Sierra-Lobo/mainboard-hardware/revA-proto/images/mainboard_original.jpg

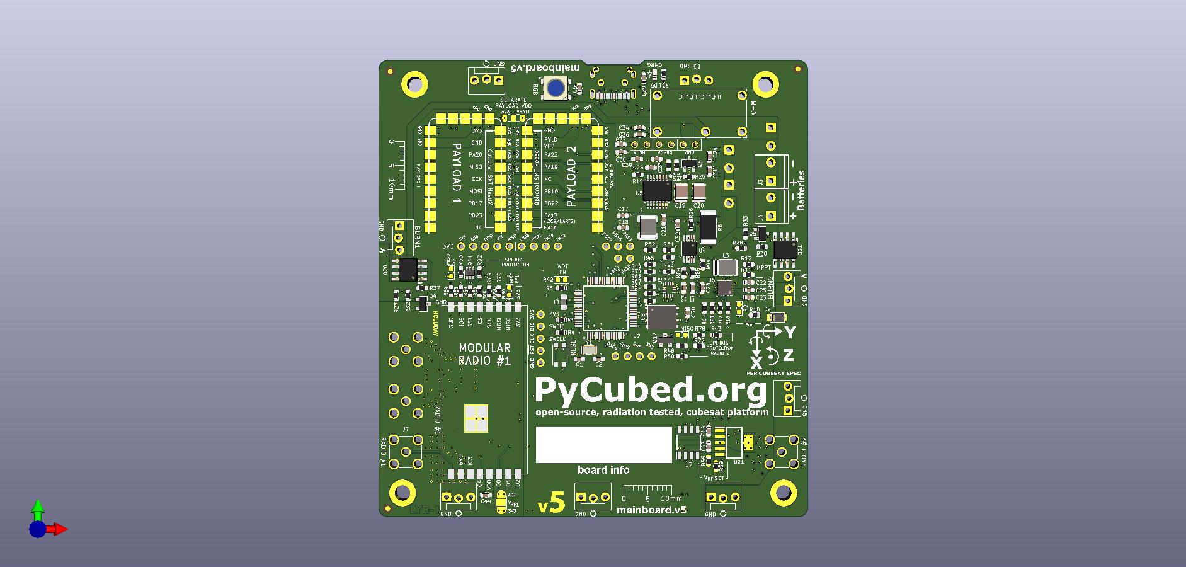
revA-proto/images/mainboard_original.jpg
