Sierra-Lobo/mainboard-hardware/revA-proto/images/mainboard.jpg

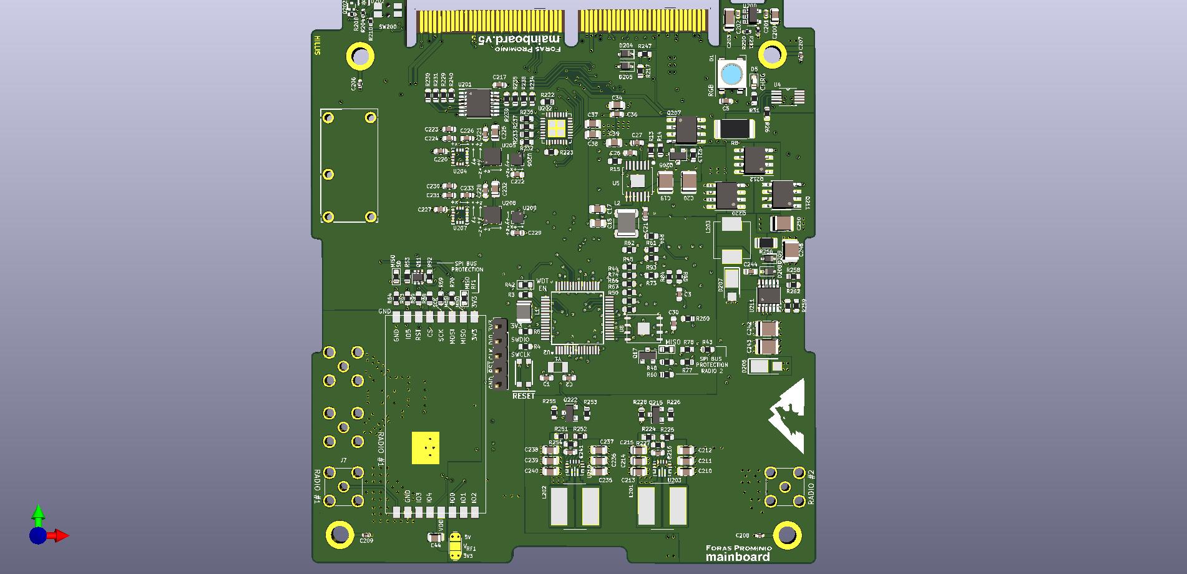
revA-proto/images/mainboard.jpg
