Sierra-Lobo/mainboard-hardware/README.md

# mainboard

PyCubed mainboard adaptation for use on Foras Promineo
