Sierra-Lobo/mainboard-hardware/design/stackup/RF_trace_calculation_1oz_1oz_FR408HR.PNG

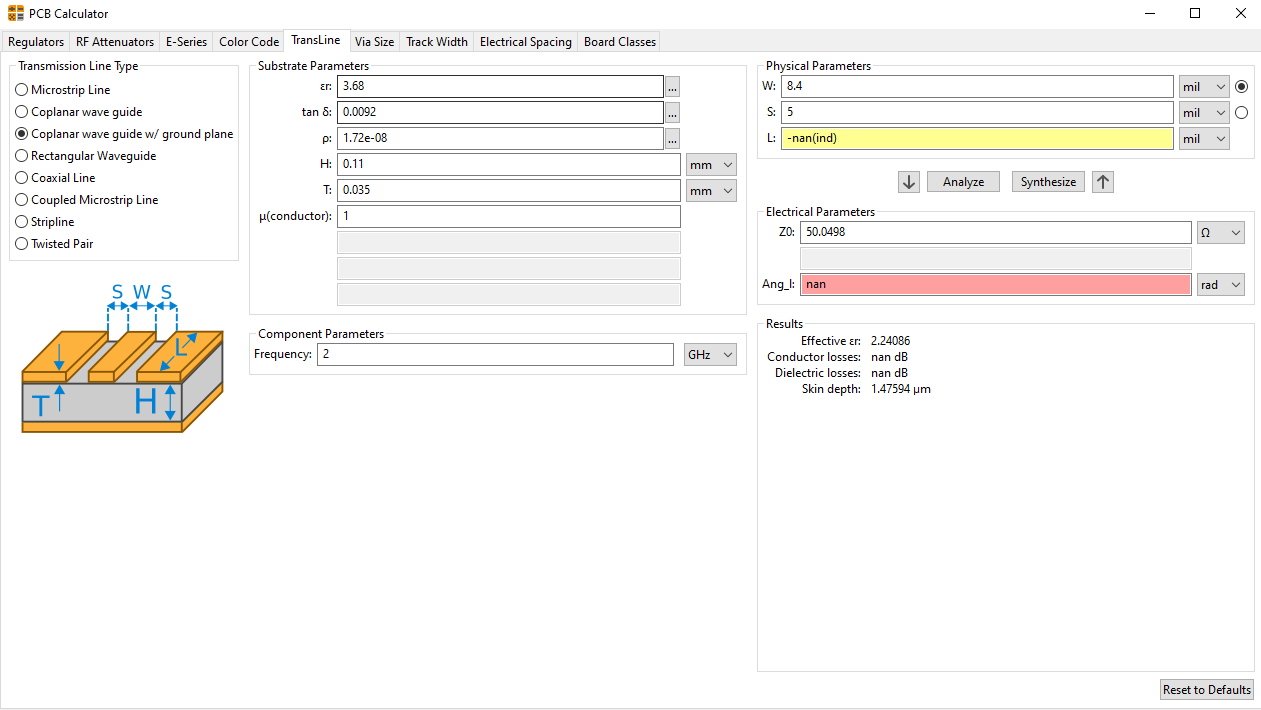
design/stackup/RF_trace_calculation_1oz_1oz_FR408HR.PNG
