Sierra-Lobo/mainboard-hardware/design/stackup/stackup.PNG

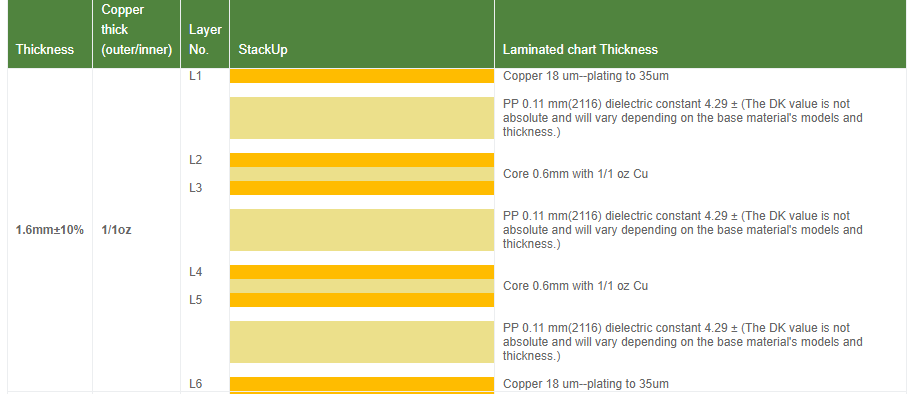
design/stackup/stackup.PNG
