Sierra-Lobo/mainboard-hardware/revC-fm/docs/mainboard-revC-3d-bot.jpg

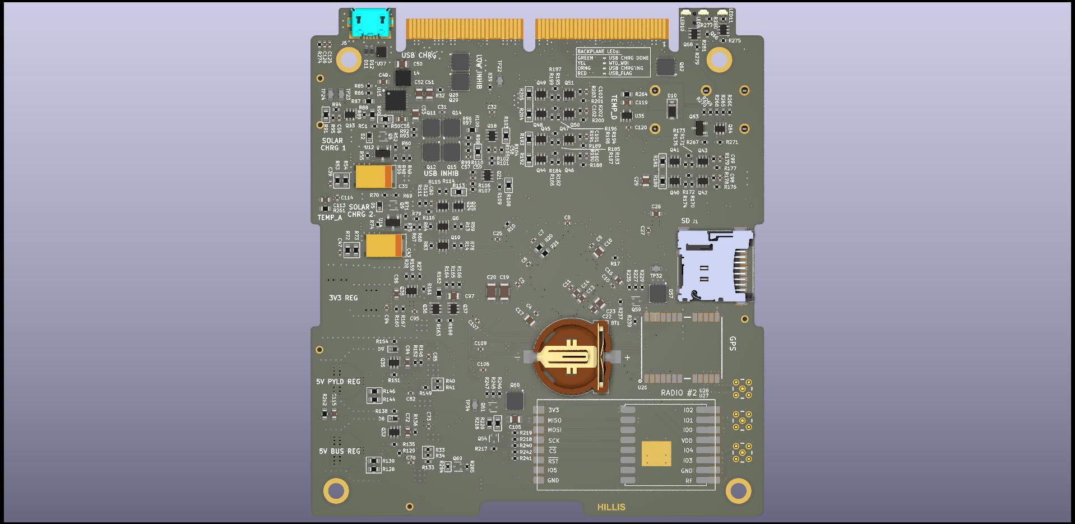
revC-fm/docs/mainboard-revC-3d-bot.jpg
