Sierra-Lobo/mainboard-hardware/revC-fm/docs/mainboard-revC-3d-top.jpg

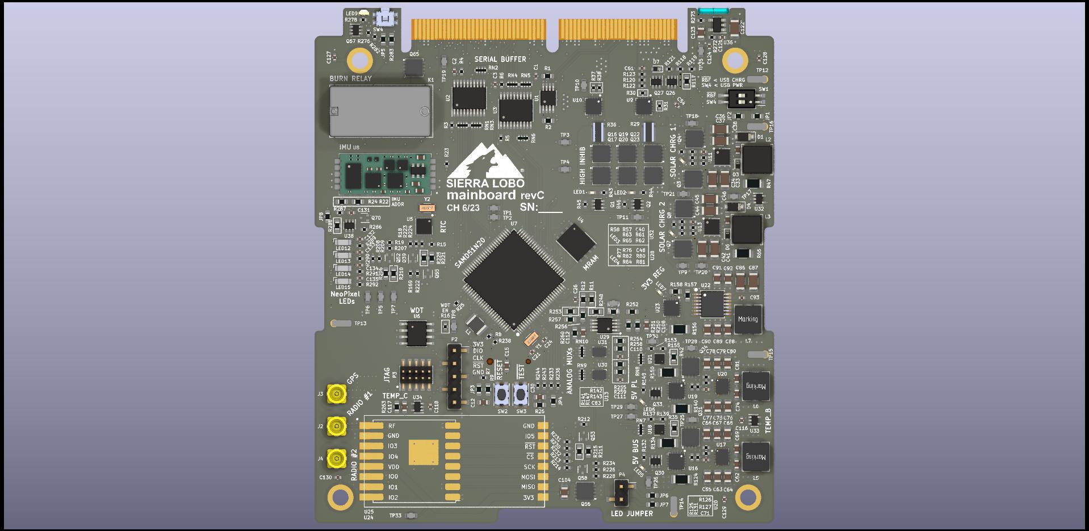
revC-fm/docs/mainboard-revC-3d-top.jpg
