Sierra-Lobo/mainboard-hardware/revC-fm/docs/stackup/PCBway_impedance_ms_se_cp_gp_50.JPG

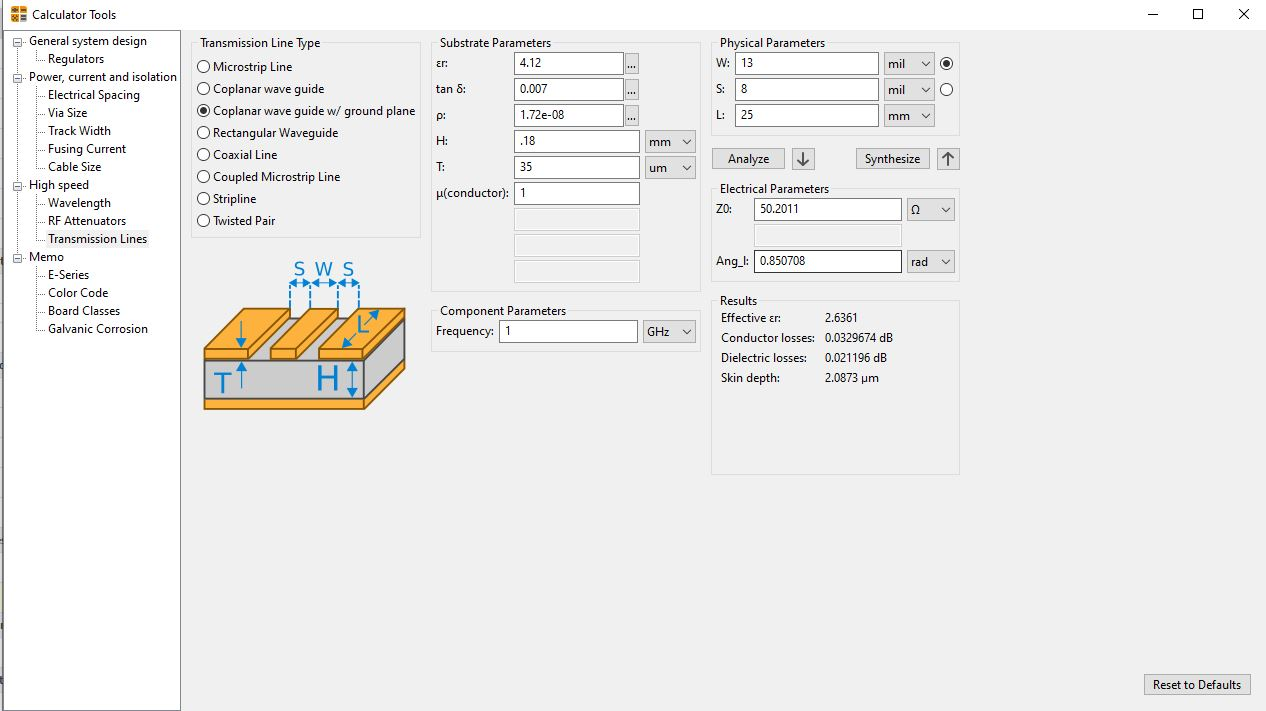
revC-fm/docs/stackup/PCBway_impedance_ms_se_cp_gp_50.JPG
