Sierra-Lobo/mainboard-hardware/revC-fm/docs/stackup/PCBway_impedance_sl_dp_90.JPG

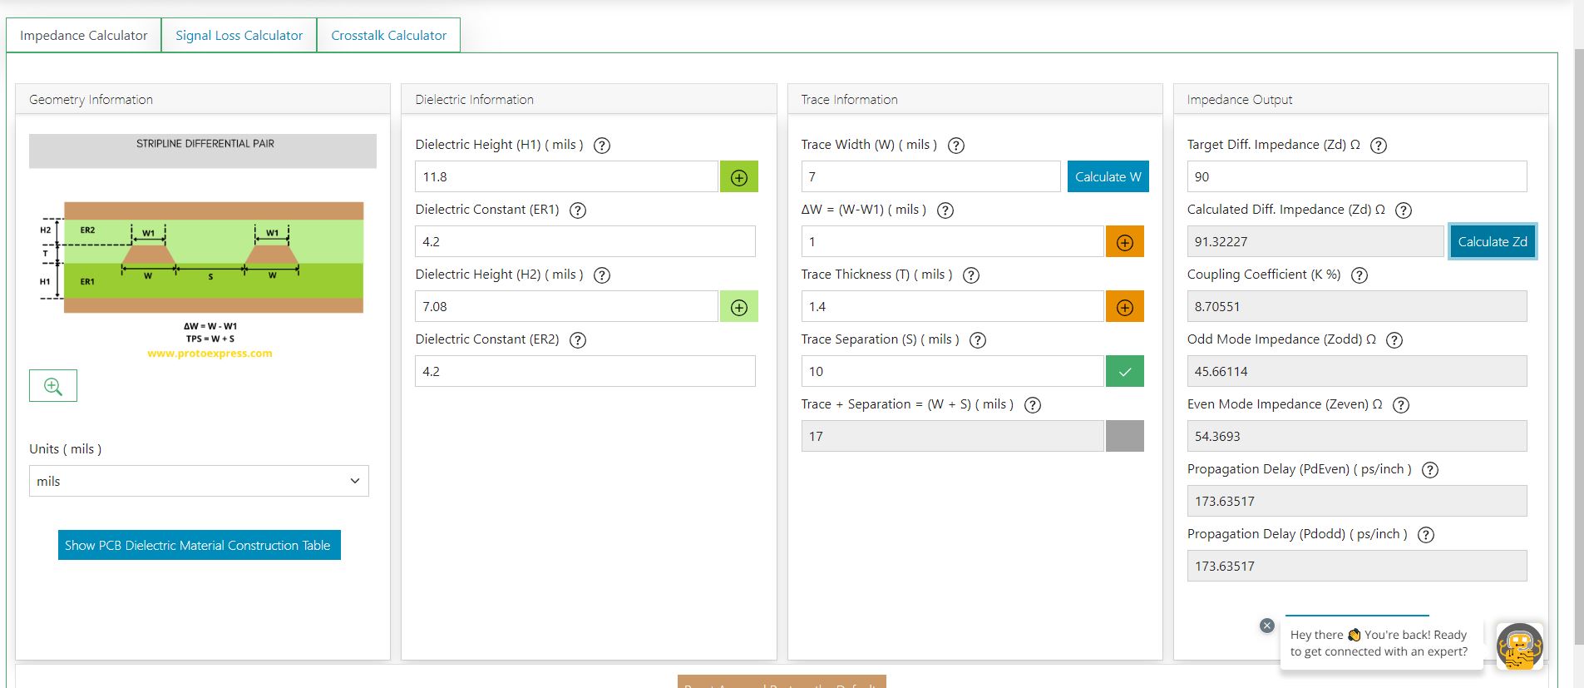
revC-fm/docs/stackup/PCBway_impedance_sl_dp_90.JPG
