Sierra-Lobo/mainboard-hardware/revC-fm/docs/stackup/PCBway_stackup.JPG

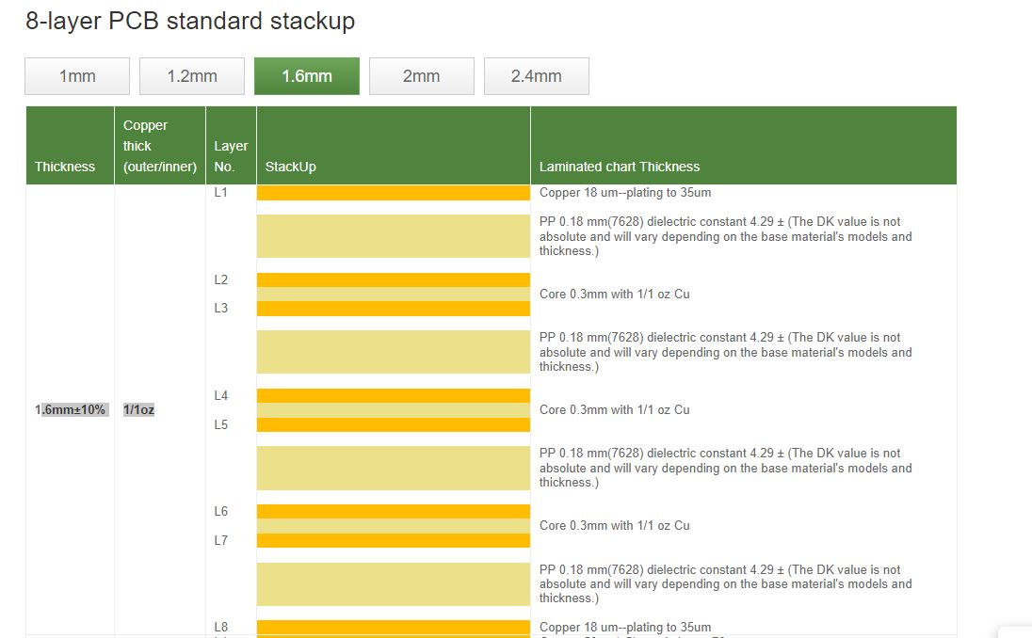
revC-fm/docs/stackup/PCBway_stackup.JPG
