Sierra-Lobo/mainboard-hardware/revC-fm/docs/mainboard-revC-assy-vendor-bom.xlsx

Item | Qty | Reference(s) | Value | Footprint | LibPart | Manufacturer | Mfr. Part No | Description | Datasheet
1 | 1 | BT1 | 1056TR | SierraLobo:Keystone_1056 | Device:Battery_Cell | Keystone Electronics | 1056TR | BATT HOLDER COIN 12.5MM 1CEL SMD | ~
2 | 8 | C1, C98, C99, C100, C101, C102, C103, C126 | 10nF | Capacitor_SMD:C_0402_1005Metric | Device:C | TDK | CGA2B3X7S2A103K050BB | CAP CER 10000PF 100V X7S 0402 | ~
3 | 50 | C2, C3, C4, C5, C6, C7, C8, C9, C10, C11, C25, C26, C27, C31, C32, C56, C57, C58, C59, C60, C61, C70, C71, C73, C82, C83, C85, C93, C95, C106, C107, C109, C110, C111, C114, C116, C118, C120, C121, C124, C125, C127, C128, C129, C130, C131, C132, C133, C134, C135 | 0.1uF | Capacitor_SMD:C_0402_1005Metric | Device:C | TDK | CGA2B3X7R1H104K050BE | CAP CER 0.1UF 50V X7R 0402 | ~
4 | 18 | C12, C13, C14, C15, C16, C22, C28, C30, C38, C46, C49, C72, C84, C96, C113, C115, C117, C119 | 1uF | Capacitor_SMD:C_0603_1608Metric | Device:C | TDK | CGA3E1X7R1V105K080AE | CAP CER 1UF 35V X7R 0603 | ~
5 | 15 | C17, C18, C23, C29, C50, C53, C66, C67, C68, C78, C79, C80, C91, C92, C123 | 10uF | Capacitor_SMD:C_0805_2012Metric | Device:C | TDK | CGA4J1X7S1E106K125AE | CAP CER 10UF 25V X7S 0805 | ~
6 | 5 | C19, C20, C86, C87, C122 | 47uF | Capacitor_SMD:C_1206_3216Metric | Device:C | TDK | C3216X5R1E476M160AC | CAP CER 47UF 25V X5R 1206 | ~
7 | 2 | C21, C24 | 8pF | Capacitor_SMD:C_0402_1005Metric | Device:C | TDK | CGA2B2NP01H080D050BA | CAP CER 8PF 50V NP0 0402 | ~
8 | 8 | C33, C34, C36, C37, C41, C42, C44, C45 | 10uF | Capacitor_SMD:C_1206_3216Metric | Device:C | TDK | CGA5L1X7R1V106M160AE | CAP CER 10UF 35V X7R 1206 | ~
9 | 2 | C35, C43 | 100uF | Capacitor_Tantalum_SMD:CP_EIA-7343-20_Kemet-V | Device:C_Polarized_US | Vishay Sprague | TR3D107K020C0080 | CAP TANT 100UF 10% 20V 2917 | ~
10 | 4 | C39, C40, C47, C48 | 33pF | Capacitor_SMD:C_0402_1005Metric | Device:C | TDK | CGA2B2NP01H330J050BA | CAP CER 33PF 50V NP0 0402 | ~
11 | 11 | C51, C52, C63, C64, C65, C75, C76, C77, C88, C89, C90 | 22uF | Capacitor_SMD:C_0805_2012Metric | Device:C | Murata | GRT21BR61C226ME13K | CAP CER 22UF 16V X5R 0805 | ~
12 | 1 | C54 | 47nF | Capacitor_SMD:C_0402_1005Metric | Device:C | TDK | CGA2B3X7R1H473K050BB | CAP CER 0.047UF 50V X7R 0402 | ~
13 | 1 | C55 | 4.7uF | Capacitor_SMD:C_0603_1608Metric | Device:C | Murata | GRT188R61C475KE13J | CAP CER 4.7UF 16V X5R 0603 | ~
14 | 4 | C62, C69, C74, C81 | 10uF | Capacitor_SMD:C_0603_1608Metric | Device:C | Murata | GRT188R61E106ME13D | CAP CER 10UF 25V X5R 0603 | ~
15 | 1 | C94 | 3.3nF | Capacitor_SMD:C_0402_1005Metric | Device:C | TDK | CGA2B2X7R1H332K050BA | CAP CER 3300PF 50V X7R 0402 | ~
16 | 2 | C97, C104 | 10uF | Capacitor_SMD:C_0805_2012Metric | Device:C_Small | TDK | CGA4J1X7S1E106K125AE | CAP CER 10UF 25V X7S 0805 | ~
17 | 2 | C108, C112 | 10nF | Capacitor_SMD:C_0603_1608Metric | Device:C | TDK | CGA3E2X7R1H103K080AE | CAP CER 10000PF 50V X7R 0603 | ~
18 | 3 | D1, D4, D10 | B260S1F-7 | Diode_SMD:D_SOD-123F | mainboard-rescue:D_Schottky-Device-mainboard-rescue | Diodes Incorporated | B260S1F-7 | DIODE SCHOTTKY 60V 2A SOD123F
19 | 2 | D2, D5 | 20V | Diode_SMD:D_SOD-523 | Device:D_Zener | Diodes Incorporated | BZT585B20T-7 | DIODE ZENER 20V 350MW SOD523 | ~
20 | 5 | D3, D6, D7, D8, D9 | 1SS400T1G | Diode_SMD:D_SOD-523 | Device:D | onsemi | 1SS400T1G | DIODE GEN PURP 100V 200MA SOD523 | ~
21 | 2 | D11, D12 | ESD321DPYR | SierraLobo:D_0402_1005Metric | Device:D_Zener | Texas Instruments | ESD321DPYR | TVS DIODE 3.6VWM 6.8VC 2X1SON | ~
22 | 1 | J1 | 5031821852 | SierraLobo:MOLEX_503182-1852 | SierraLobo:503182-1852 | Molex | 5031821852 | MICRO SD NORMAL ULTRALOWPRO8CKTE
23 | 1 | J5 | ZX62-AB-5PA(31) | SierraLobo:ZX62-AB-5PA(31) | Connector:USB_B_Micro | Hirose Electric | ZX62-AB-5PA(31) | CONN RCPT USB2.0 MICRO AB SMD RA | ~
24 | 1 | L1 | 10uH | Inductor_SMD:L_1210_3225Metric | Device:L | TDK | BCL322520RT-100M-D | FIXED IND WW SHEILD 10UH 1.72A 230MOHM 1210 | ~
25 | 2 | L2, L3 | 33uH | Inductor_SMD:L_Coilcraft_XAL5050-XXX | Device:L | Coilcraft | XGL5050-333MEC | FIXED IND MLD SHEILD 33UH 3.2A 118MOHM 5050 | ~
26 | 1 | L4 | 1uH | SierraLobo:74404032010 | Device:L | WÃ¼rth Elektronik | 74404032010 | FIXED IND SHEILD 1UH 2.2A 33 MOHM 3015 | ~
27 | 2 | L5, L6 | 1.5uH | SierraLobo:L_Wuerth_HCI-5040 | Device:L | WÃ¼rth Elektronik | 744316150 | FIXED IND SHEILD 1.5UH 9A 8.15 MOHM 5040 | ~
28 | 1 | L7 | 3.3uH | SierraLobo:L_Wuerth_HCI-5040 | Device:L | WÃ¼rth Elektronik | 744316330 | FIXED IND SHEILD3.3UH 5.75A 18.5 MOHM 5040 | ~
29 | 7 | LED1, LED2, LED3, LED4, LED5, LED6, LED7 | YEL | LED_SMD:LED_0402_1005Metric | Device:LED | Kingbright | APHHS1005LSYCK/J3-PF | LED YELLOW CLEAR 2SMD | ~
30 | 1 | LED8 | YELLOW | SierraLobo:APA2107x | Device:D | Kingbright | APA2107SYCK | LED YELLOW CLEAR SMD R/A | ~
31 | 1 | LED9 | GREEN | SierraLobo:APA2107x | Device:D | Kingbright | APA2107CGCK | LED GREEN CLEAR SMD R/A | ~
32 | 1 | LED10 | ORANGE | SierraLobo:APA2107x | Device:D | Kingbright | APA2107SECK | LED ORANGE CLEAR SMD R/A | ~
33 | 1 | LED11 | RED | SierraLobo:APA2107x | Device:D | Kingbright | APA2107LSECK | LED RED CLEAR SMD R/A | ~
34 | 1 | P3 | FTSH-105-01-F-DV-K-TR | Connector_PinHeader_1.27mm:PinHeader_2x05_P1.27mm_Vertical_SMD | Connector_Generic:Conn_02x05_Odd_Even | Samtec | FTSH-105-01-F-DV-K-TR | CONN HEADER SMD 10POS 1.27MM | ~
35 | 1 | P4 | TSM-102-01-L-SV-P-TR | Connector_PinHeader_2.54mm:PinHeader_1x02_P2.54mm_Vertical_SMD_Pin1Right | Connector_Generic:Conn_01x02 | Samtec | TSM-102-01-L-SV-P-TR | CONN HEADER SMD 2POS 2.54MM | ~
36 | 17 | Q1, Q2, Q6, Q10, Q13, Q18, Q21, Q24, Q27, Q30, Q32, Q33, Q35, Q38, Q66, Q67, Q68 | MMDT3946 | Package_TO_SOT_SMD:SOT-363_SC-70-6 | Transistor_BJT:MMDT3946 | Diodes Incorporated | MMDT3946-7-F | TRANS NPN/PNP 40V 0.2A SOT363 | http://www.diodes.com/_files/datasheets/ds30123.pdf
37 | 20 | Q3, Q4, Q7, Q8, Q11, Q12, Q14, Q15, Q16, Q17, Q19, Q20, Q22, Q23, Q31, Q34, Q56, Q57, Q62, Q65 | BSZ180 | SierraLobo:PG-TSDSON-8_3.3x3.3mm | SierraLobo:BSZ086 | Infineon | BSZ180P03NS3GATMA1 | MOSFET P-CH 30V 9A/39.6A TSDSON | https://www.infineon.com/dgdl/Infineon-BSZ180P03NS3_G-DS-v02_01-en.pdf?fileId=db3a304326dfb13001271f04398f4ec1
38 | 6 | Q5, Q9, Q39, Q58, Q59, Q69 | MMBT3904T | Package_TO_SOT_SMD:SOT-523 | Device:Q_NPN_BEC | Diodes Incorporated | MMBT3904T-7-F | TRANS NPN 40V 0.2A SOT523 | https://www.diodes.com/assets/Datasheets/ds30270.pdf
39 | 11 | Q25, Q26, Q36, Q37, Q40, Q41, Q44, Q45, Q48, Q49, Q64 | MMDT5551-7-F | Package_TO_SOT_SMD:SOT-363_SC-70-6 | Transistor_BJT:MMDT5551 | Diodes Incorporated | MMDT5551-7-F | TRANS 2NPN 160V 0.2A SOT363 | http://www.diodes.com/_files/datasheets/ds30172.pdf
40 | 2 | Q28, Q29 | BSZ025 | SierraLobo:PG-TSDSON-8_3.3x3.3mm | SierraLobo:BSZ025 | Infineon | BSZ025N04LSATMA1 | MOSFET N-CH 40V 22A/40A TSDSON | https://www.infineon.com/dgdl/DS_BSZ025N04LS_2_1.pdf?fileId=5546d46146d18cb40147204a34530283
41 | 6 | Q42, Q43, Q46, Q47, Q50, Q51 | BSS138DWQ-7 | Package_TO_SOT_SMD:SOT-363_SC-70-6 | SierraLobo:BSS138DW | Diodes Incorporated | BSS138DWQ-7 | MOSFET 2NCH 50V 200MA SOT363 | https://www.diodes.com/assets/Datasheets/BSS138DWQ.pdf
42 | 5 | Q52, Q53, Q54, Q55, Q70 | MMBT3906T | Package_TO_SOT_SMD:SOT-523 | Device:Q_PNP_BEC | Diodes Incorporated | MMBT3906T-7-F | TRANS PNP 40V 0.2A SOT523 | https://www.diodes.com/assets/Datasheets/ds30271.pdf
43 | 1 | Q63 | IRLML2803 | Package_TO_SOT_SMD:SOT-23 | Device:Q_NMOS_GSD | Infineon | IRLML2803TRPBF | MOSFET N-CH 30V 1.2A SOT23 | ~
44 | 4 | R1, R2, R20, R21 | 2.7k | Resistor_SMD:R_0603_1608Metric | Device:R_US | Stackpole Electronics | RMCF0603FT2K70 | RES 2.7K OHM 1% 1/10W 0603 | ~
45 | 61 | R3, R4, R5, R6, R13, R14, R27, R28, R30, R31, R33, R34, R37, R38, R40, R41, R48, R50, R67, R69, R92, R93, R96, R97, R101, R102, R106, R107, R111, R112, R122, R123, R135, R139, R151, R155, R208, R209, R213, R214, R218, R219, R223, R224, R228, R229, R231, R232, R233, R236, R237, R238, R239, R266, R267, R270, R287, R289, R290, R291, R292 | 1k | Resistor_SMD:R_0402_1005Metric | Device:R_US | Panasonic | ERJ-2GEJ102X | RES SMD 1K OHM 5% 1/10W 0402 | ~
46 | 39 | R7, R8, R10, R15, R16, R17, R18, R19, R23, R25, R32, R39, R85, R89, R129, R137, R145, R153, R159, R166, R169, R170, R171, R172, R173, R182, R183, R184, R185, R194, R195, R196, R197, R230, R272, R273, R275, R285, R286 | 10k | Resistor_SMD:R_0402_1005Metric | Device:R_US | Stackpole Electronics | RMCF0402FT10K0 | RES 10K OHM 1% 1/16W 0402 | ~
47 | 2 | R9, R26 | 330 | Resistor_SMD:R_0603_1608Metric | Device:R_US | Stackpole Electronics | RMCF0603FT330R | RES 330 OHM 1% 1/10W 0603 | ~
48 | 1 | R11 | 316k | Resistor_SMD:R_0603_1608Metric | Device:R_US | Stackpole Electronics | RMCF0603FT316K | RES 316K OHM 1% 1/10W 0603 | ~
49 | 3 | R12, R256, R260 | 110k | Resistor_SMD:R_0603_1608Metric | Device:R_US | Stackpole Electronics | RMCF0603FT110K | RES 110K OHM 1% 1/10W 0603 | ~
50 | 1 | R22 | 976k | Resistor_SMD:R_0603_1608Metric | Device:R_US | Stackpole Electronics | RMCF0603FT976K | RES 976K OHM 1% 1/10W 0603 | ~
51 | 1 | R24 | 102k | Resistor_SMD:R_0603_1608Metric | Device:R_US | Stackpole Electronics | RMCF0603FG102K | RES 102K OHM 1% 1/10W 0603 | ~
52 | 2 | R29, R36 | 10mR | SierraLobo:KRL3216 | SierraLobo:R_US_SENSE | Susumu | KRL3216T4A-M-R010-F-T1 | RES 0.01 OHM 1W 1206 WIDE | ~
53 | 2 | R35, R42 | 499 | Resistor_SMD:R_0603_1608Metric | Device:R_US | Stackpole Electronics | RMCF0603FT499R | RES 499 OHM 1% 1/10W 0603 | ~
54 | 11 | R43, R44, R60, R79, R132, R148, R161, R277, R278, R279, R280 | 1.5k | Resistor_SMD:R_0402_1005Metric | Device:R_US | Stackpole Electronics | RMCF0402FT1K50 | RES 1.5K OHM 1% 1/16W 0402 | ~
55 | 50 | R45, R46, R49, R51, R55, R58, R59, R64, R68, R70, R74, R77, R78, R83, R94, R125, R126, R127, R131, R133, R136, R138, R141, R142, R143, R147, R149, R152, R154, R160, R163, R165, R167, R176, R177, R188, R189, R200, R201, R226, R227, R234, R235, R265, R268, R269, R271, R276, R281, R282 | 100k | Resistor_SMD:R_0402_1005Metric | Device:R_US | Stackpole Electronics | RMCF0402FT100K | RES 100K OHM 1% 1/16W 0402 | ~
56 | 2 | R47, R66 | 120mR | Resistor_SMD:R_1206_3216Metric | Device:R_US | Susumu | KRL1632E-M-R120-F-T5 | RES 0.12 OHM 1% 3/4W 1206 | ~
57 | 2 | R52, R71 | 180k | Resistor_SMD:R_0402_1005Metric | Device:R_US | Stackpole Electronics | RMCF0402FT180K | RES 180K OHM 1% 1/16W 0402 | ~
58 | 2 | R53, R72 | 634k | Resistor_SMD:R_0603_1608Metric | Device:R_US | Stackpole Electronics | RMCF0603FT634K | RES 634K OHM 1% 1/10W 0603 | ~
59 | 2 | R54, R73 | 412k | Resistor_SMD:R_0603_1608Metric | Device:R_US | Stackpole Electronics | RMCF0603FT412K | RES 412K OHM 1% 1/10W 0603 | ~
60 | 2 | R56, R75 | 2.61k | Resistor_SMD:R_0402_1005Metric | Device:R_US | Stackpole Electronics | RMCF0402FT2K61 | RES 2.61K OHM 1% 1/16W 0402 | ~
61 | 10 | R57, R76, R104, R109, R114, R115, R118, R119, R121, R274 | 1Meg | Resistor_SMD:R_0402_1005Metric | Device:R_US | Stackpole Electronics | RMCF0402FT1M00 | RES 1M OHM 1% 1/16W 0402 | ~
62 | 2 | R61, R80 | 140k | Resistor_SMD:R_0402_1005Metric | Device:R_US | Stackpole Electronics | RMCF0402FT140K | RES 140K OHM 1% 1/16W 0402 | ~
63 | 2 | R62, R81 | 2.8k | Resistor_SMD:R_0402_1005Metric | Device:R_US | Stackpole Electronics | RMCF0402FT2K80 | RES 2.8K OHM 1% 1/16W 0402 | ~
64 | 2 | R63, R82 | 32.4k | Resistor_SMD:R_0402_1005Metric | Device:R_US | Stackpole Electronics | RMCF0402FT32K4 | RES 32.4K OHM 1% 1/16W 0402 | ~
65 | 2 | R65, R84 | 24.9k | Resistor_SMD:R_0402_1005Metric | Device:R_US | Stackpole Electronics | RMCF0402FT24K9 | RES 24.9K OHM 1% 1/16W 0402 | ~
66 | 1 | R87 | 5.23k | Resistor_SMD:R_0603_1608Metric | Device:R_US | Stackpole Electronics | RMCF0603FT5K23 | RES 5.23K OHM 1% 1/10W 0603 | ~
67 | 1 | R88 | 30.1k | Resistor_SMD:R_0603_1608Metric | Device:R_US | Stackpole Electronics | RMCF0603FG30K1 | RES 30.1K OHM 1% 1/10W 0603 | ~
68 | 1 | R90 | 3.16k | Resistor_SMD:R_0603_1608Metric | Device:R_US | Stackpole Electronics | RMCF0603FT3K16 | RES 3.16K OHM 1% 1/10W 0603 | ~
69 | 13 | R91, R98, R100, R103, R108, R113, R117, R128, R144, R206, R211, R216, R221 | 0 | Resistor_SMD:R_0603_1608Metric | Device:R_US | Stackpole Electronics | RMCF0603ZT0R00 | RES 0 OHM JUMPER 1/10W 0603 | ~
70 | 6 | R95, R99, R105, R110, R116, R120 | 220k | Resistor_SMD:R_0402_1005Metric | Device:R_US | Stackpole Electronics | RMCF0402FT220K | RES 220K OHM 1% 1/16W 0402 | ~
71 | 3 | R124, R140, R156 | 10mR | Resistor_SMD:R_1206_3216Metric | Device:R_US | Vishay Dale | WSLP1206R0100 | RES 0.01 OHM 1% 1W 1206 | ~
72 | 2 | R134, R150 | 22mR | Resistor_SMD:R_1206_3216Metric | Device:R_US | Vishay Dale | WSLP1206R0220 | RES 0.022 OHM 1% 1W 1206 | ~
73 | 2 | R157, R162 | 73.2k | Resistor_SMD:R_0603_1608Metric | Device:R_US | Stackpole Electronics | RMCF0603FT73K2 | RES 73.2K OHM 1% 1/10W 0603 | ~
74 | 1 | R158 | 22.1k | Resistor_SMD:R_0603_1608Metric | Device:R_US | Stackpole Electronics | RMCF0603FT22K1 | RES 22.1K OHM 1% 1/10W 0603 | ~
75 | 7 | R164, R178, R179, R190, R191, R202, R203 | 200k | Resistor_SMD:R_0402_1005Metric | Device:R_US | Stackpole Electronics | RMCF0402FT200K | RES 200K OHM 1% 1/16W 0402 | ~
76 | 1 | R168 | 20k | Resistor_SMD:R_0402_1005Metric | Device:R_US | Stackpole Electronics | RMCF0402FT20K0 | RES 20K OHM 1% 1/16W 0402 | ~
77 | 6 | R174, R175, R186, R187, R198, R199 | 680 | Resistor_SMD:R_0402_1005Metric | Device:R_US | Stackpole Electronics | RMCF0402FT680R | RES 680 OHM 1% 1/16W 0402 | ~
78 | 4 | R207, R212, R217, R222 | 4.7k | Resistor_SMD:R_0402_1005Metric | Device:R_US | Stackpole Electronics | RMCF0402FT4K70 | RES 4.7K OHM 1% 1/16W 0402 | ~
79 | 2 | R249, R251 | 10k | Resistor_SMD:R_0603_1608Metric | Device:R_US | Stackpole Electronics | RMCF0603FT10K0 | RES 10K OHM 1% 1/10W 0603 | ~
80 | 2 | R254, R255 | 232k | Resistor_SMD:R_0603_1608Metric | Device:R_US | Stackpole Electronics | RMCF0603FT232K | RES 232K OHM 1% 1/10W 0603 | https://www.seielect.com/Catalog/SEI-RMCF_RMCP.pdf
81 | 1 | R257 | 1k | Resistor_SMD:R_0603_1608Metric | Device:R_US | Stackpole Electronics | RMCF0603FG1K00 | RES 1K OHM 1% 1/10W 0603 | ~
82 | 2 | R258, R259 | 33k | Resistor_SMD:R_0603_1608Metric | Device:R_US | Stackpole Electronics | RMCF0603FT33K0 | RES 33K OHM 1% 1/10W 0603 | ~
83 | 4 | R261, R262, R263, R264 | 220 | Resistor_SMD:R_0603_1608Metric | Device:R_US | Stackpole Electronics | RMCF0603FT220R | RES 220 OHM 1% 1/10W 0603 | ~
84 | 9 | RN1, RN3, RN4, RN5, RN6, RN7, RN8, RN9, RN10 | 1k | Resistor_SMD:R_Array_Convex_4x0402 | :R_Network04_US_3 | Stackpole Electronics | RAVF164DJT1K00 | RES ARRAY 4 RES 1K OHM 1206
85 | 1 | RN2 | 10k | Resistor_SMD:R_Array_Convex_4x0402 | SierraLobo:R_Network04_US | Stackpole Electronics | RAVF164DJT10K0 | RES ARRAY 4 RES 10K OHM 1206
86 | 1 | SW1 | 1571983-1 | SierraLobo:SW_DIP_SPSTx02_Slide_TE_GDH | Switch:SW_DIP_x02 | TE Connectivity | 1571983-1 | SWITCH SLIDE DIP SPST 25MA 24V | ~
87 | 2 | SW2, SW3 | KMR231NG LFS | SierraLobo:KMR2_4.6X2.8 | Switch:SW_SPST | C&K | KMR231NG LFS | Tactile Switch SPST-NO Top Actuated Surface Mount | ~
88 | 1 | SW4 | EVQP7C01P | SierraLobo:EVQP7C01P | mainboard-rescue:SW_Push-Switch-mainboard-rescue | Panasonic | EVQP7C01P | SWITCH TACTILE SPST-NO 0.05A 12V
89 | 30 | TP1, TP2, TP3, TP4, TP5, TP6, TP7, TP8, TP9, TP10, TP11, TP17, TP18, TP19, TP20, TP21, TP22, TP23, TP24, TP25, TP26, TP27, TP28, TP29, TP30, TP31, TP32, TP33, TP34, TP35 | RCU-0C | SierraLobo:TestPoint_TE_RCU_0603 | Connector:TestPoint | TE | RCU-0C | PC TEST POINT NATURAL 0603 | https://www.digikey.com/en/products/detail/te-connectivity-amp-connectors/RCU-0C/2366048
90 | 1 | U1 | LTC4307I | Package_SO:MSOP-8_3x3mm_P0.65mm | mainboard_SLI:LTC4307 | Analog Devices | LTC4307IMS8#TRPBF | IC ACCELERATOR I2C HOTSWAP 8MSOP
91 | 2 | U2, U3 | SN74LVCH245APWR | Package_SO:TSSOP-20_4.4x6.5mm_P0.65mm | SierraLobo:SN74LVCH245APWR | Texas Instruments | SN74LVCH245APWR | IC TXRX NON-INVERT 3.6V 20TSSOP
92 | 1 | U4 | MR25H40MDF | Package_DFN_QFN:DFN-8-1EP_6x5mm_P1.27mm_EP2x2mm | SierraLobo:MR25H40MDF | Everspin Technologies | MR25H40MDF | IC RAM 4MBIT SPI 40MHZ 8DFN
93 | 1 | U5 | DS1343D-33+ | Package_DFN_QFN:DFN-14-1EP_3x3mm_P0.4mm_EP1.78x2.35mm | SierraLobo:DS1343D-33+ | Analog Devices/Maxim Integrated | DS1343D-33+ | IC RTC CLK/CALENDAR SPI 14TDFN | https://www.analog.com/media/en/technical-documentation/data-sheets/ds1343-ds1344.pdf
94 | 1 | U6 | MAX708RESA-T | Package_SO:SO-8_3.9x4.9mm_P1.27mm | SierraLobo:MAX708RESA-T | Analog Devices/Maxim Integrated | MAX708RESA-T | IC SUPERVISOR 1 CHANNEL 8SOIC
95 | 5 | U9, U10, U16, U19, U23 | INA230AIRGTR | SierraLobo:INA230AIRGTR | SierraLobo:INA230AxRGT | Texas Instruments | INA230AIRGTR | IC CURRENT MONITOR 0.005 16VQFN | http://www.ti.com/lit/ds/symlink/ina226.pdf
96 | 2 | U11, U13 | LT3652HV | Package_DFN_QFN:DFN-12-1EP_3x3mm_P0.45mm_EP1.66x2.38mm | SierraLobo:LTC3652HV | Analog Devices | LT3652HVEDD#PBF | IC BAT CHG MULT-CHEM 4-5CL 12DFN
97 | 2 | U12, U14 | ATL431BQ | Package_TO_SOT_SMD:SOT-23 | SierraLobo:ATL431BQ | Texas Instruments | ATL431BQ | IC VREF SHUNT ADJ 0.5% SOT23-3
98 | 1 | U15 | BQ25883RGER | SierraLobo:QFN50P400X400X100-25N-D | SierraLobo:BQ25883RGER | Texas Instruments | BQ25883RGER | BQ25883RGER | http://www.ti.com/lit/ds/symlink/bq25883.pdf?HQS=TI-null-null-mousermode-df-pf-null-wwe&DCM=yes
99 | 2 | U17, U20 | TPS630701RNMR | SierraLobo:TPS63070RNMR | SierraLobo:TPS63070 | Texas Instruments | TPS630701RNMR | IC REG BCK BST 5V 2A 15VQFN
100 | 2 | U18, U21 | INA300AIDSQT | SierraLobo:WSON-10_2x2mm_P0.4mm_EP | SierraLobo:INA300xQ1-DGS | Vishay Siliconix | INA300AIDSQT | IC CURRENT SENSE 10WSON
101 | 1 | U22 | TPS54226PWPR | SierraLobo:PWP14_2P31X2P46-L | SierraLobo:TPS54226PWPR_ | Texas Instruments | TPS54226PWPR | TPS54226PWPR
102 | 1 | U29 | LT6004CMS8#PBF | Package_SO:MSOP-8_3x3mm_P0.65mm | SierraLobo:LT6004CMS8#PBF | Analog Devices | LT6004CMS8#PBF | IC OPAMP GP 2 CIRCUIT 8MSOP
103 | 1 | U30 | DG4052E | SierraLobo:MINI-QFN-16L | SierraLobo:DG4052E | Vishay Siliconix | DG4052EEN-T1-GE4 | IC SWITCH SP4TX2 78OHM 16MINIQFN | DG4052EEN-T1-GE4
104 | 1 | U31 | DG4051E | SierraLobo:MINI-QFN-16L | SierraLobo:DG4051E | Vishay Siliconix | DG4051EEN-T1-GE4 | IC MUX 8:1 78OHM 16MINIQFN | DG4051EEN-T1-GE4
105 | 4 | U32, U33, U34, U35 | MCP9700AT-E/LT | Package_TO_SOT_SMD:SOT-353_SC-70-5 | Sensor_Temperature:MCP9700Ax-ELT | Microchip Technology | MCP9700AT-E/LT | SENSOR ANALOG -40C-125C SC70-5 | http://ww1.microchip.com/downloads/en/DeviceDoc/20001942G.pdf
106 | 1 | U36 | AP2161W | Package_TO_SOT_SMD:SOT-23-5 | Power_Management:AP2161W | Diodes Incorporated | AP2161W | IC PWR SWITCH P-CHAN 1:1 SOT25 | https://www.diodes.com/assets/Datasheets/AP2161.pdf
107 | 1 | U37 | TVS0500DRV | Package_SON:WSON-6-1EP_2x2mm_P0.65mm_EP1x1.6mm | Power_Protection:TVS0500DRV | Vishay Siliconix | TVS0500DRV | UNIDIR PRECISION SURGE DIODE | http://www.ti.com/lit/ds/symlink/tvs0500.pdf
108 | 1 | U38 | SN74LVC1T45DCK | Package_TO_SOT_SMD:SOT-363_SC-70-6 | Logic_LevelTranslator:SN74LVC1T45DCK | Texas Instruments | SN74LVC1T45DCK | IC TRANSLTR BIDIRECTIONAL SC70-6 | http://www.ti.com/lit/ds/symlink/sn74lvc1t45.pdf
109 | 2 | Y1, Y2 | 32.768kHz | SierraLobo:Crystal_SMD_3215-2Pin_3.2x1.5mm | Device:Crystal | Abracon | ABS07AIG-32.768KHZ-1-T | CRYSTAL 32.7680KHZ 12.5PF SMD | https://abracon.com/datasheets/ABS07AIG.pdf
Total | 578 |  | 109 |  |  |  |  |  | 94
