Sierra-Lobo/mainboard-hardware/revA-proto/bom/mainboard-updated-bom-inprogress.xlsx

mainboard-test
Ref | Qnty | Value | Cmp name | Footprint | Description | Vendor
C1, C2, | 2 | 8pF | C-Device-mainboard-rescue | Capacitor_SMD:C_0603_1608Metric
C3, C5, C10, C11, C21, C30, C216, C217, C218, C219, C224, C231, C234, C241, C251, C252, C253, | 17 | 0.1uF | C-Device-mainboard-rescue | Capacitor_SMD:C_0603_1608Metric
C4, C12, C13, C15, C27, C33, C221, C222, C228, C229, C244, | 11 | 1uF | C-Device-mainboard-rescue | Capacitor_SMD:C_0603_1608Metric
C6, C14, C16, C35, C39, C44, C46, C200, C210, C211, C212, C225, C232, C235, C236, C237, | 16 | 10uF | C-Device-mainboard-rescue | Capacitor_SMD:C_0805_2012Metric
C8, C40, C41, C42, C220, C227, | 6 | 10nF | C-Device-mainboard-rescue | Capacitor_SMD:C_0603_1608Metric
C17, C18, C37, C38, C213, C214, C215, C238, C239, C240, | 10 | 22uF | C-Device-mainboard-rescue | Capacitor_SMD:C_0805_2012Metric
C19, C20, C249, C250, | 4 | 100uF | C-Device-mainboard-rescue | Capacitor_SMD:C_1210_3225Metric
C26, C32, | 2 | 3.3nF | C-Device-mainboard-rescue | Capacitor_SMD:C_0603_1608Metric
C34, | 1 | 4.7uF | C-Device-mainboard-rescue | Capacitor_SMD:C_0805_2012Metric
C36, | 1 | 47nF | C-Device-mainboard-rescue | Capacitor_SMD:C_0603_1608Metric
C201, C202, C204, C206, C207, C208, C209, | 7 | 0.1uF | C-Device-mainboard-rescue | Capacitor_SMD:C_0402_1005Metric
C203, | 1 | 47uF | C-Device-mainboard-rescue | Capacitor_SMD:C_1206_3216Metric
C205, | 1 | 1nF | C-Device-mainboard-rescue | Capacitor_SMD:C_0402_1005Metric
C223, C230, | 2 | 2.2uF | C-Device-mainboard-rescue | Capacitor_SMD:C_0603_1608Metric
C226, C233, | 2 | 0.47uF | C-Device-mainboard-rescue | Capacitor_SMD:C_0603_1608Metric
C242, C243, C245, C246, C247, C248, | 6 | 10uF | C-Device-mainboard-rescue | Capacitor_SMD:C_1210_3225Metric
D1, | 1 | WS2812B | WS2812B-LED-mainboard-rescue | LED_SMD:LED_WS2812B_PLCC4_5.0x5.0mm_P3.2mm
D4, | 1 | DFLS130L | DFLS130L | mainboard:PWRDI-123
D200, | 1 | RED | D-Device-mainboard-rescue | SLI-Blank-Card:APA2107x
D201, | 1 | YELLOW | D-Device-mainboard-rescue | SLI-Blank-Card:APA2107x
D202, | 1 | GREEN | D-Device-mainboard-rescue | SLI-Blank-Card:APA2107x
D203, | 1 | ORANGE | D-Device-mainboard-rescue | SLI-Blank-Card:APA2107x
D204, D205, D208, D209, | 4 | 1N4148WSTR | D-Device-mainboard-rescue | Diode_SMD:D_SOD-323
D206, D207, | 2 | V4PAL45HM3_A/I | D_Schottky-Device-mainboard-rescue | mainboard-SLI:SMPA
H200, | 1 | MountingHole_Pad | MountingHole_Pad-Mechanical-mainboard-rescue | SLI-Backplane-Blank-Card-KiCad:125mil_hole
H201, H202, H203, | 3 | SLI-Backplane-Blank-Card-KiCad:125mil_hole | MountingHole_Pad-Mechanical-mainboard-rescue | SLI-Backplane-Blank-Card-KiCad:125mil_hole
J1, | 1 | 503182-1852 | 503182-1852 | mainboard:MOLEX_503182-1852
J2, | 1 | Conn_01x05 | Conn_01x05-Connector_Generic-mainboard-rescue | Connector_PinHeader_2.54mm:PinHeader_1x05_P2.54mm_Vertical
J5, J6, J7, J12, | 4 | Amphenol_901-144 | Conn_Coaxial-Connector-mainboard-rescue | Connector_Coaxial:SMA_Amphenol_901-144_Vertical
J200, | 1 | ZX62-AB-5PA(31) | USB_B_Micro-Connector-mainboard-rescue | SLI-Backplane-Blank-Card-KiCad:ZX62-AB-5PA(31)
J201, | 1 | TSM-102-01-L-SV-P-TR | Conn_01x02 | Connector_PinSocket_2.54mm:PinSocket_1x02_P2.54mm_Vertical_SMD_Pin1Right | Generic connector, single row, 01x02, script generated (kicad-library-utils/schlib/autogen/connector/)
JP6, JP7, | 2 | Jumper_3_Bridged12 | Jumper_3_Bridged12-Jumper-mainboard-rescue | mainboard:SolderJumper-3_P1.3mm_Bridged12_RoundedPad1.0x1.5mm
L1, | 1 | 10uH | INDUCTOR-Adafruit_Feather_M4_Express-eagle-import-lab64_SAM32-rescue-SAMD-10-rescue-SAM32-rescue | Inductor_SMD:L_1210_3225Metric
L2, | 1 | 3.3uH | L-Device-mainboard-rescue | mainboard:L_2141
L4, | 1 | 1uH | L-Device-mainboard-rescue | mainboard:L_2510
L201, L202, | 2 | 1.5uH | L-Device-mainboard-rescue | Inductor_SMD:L_Bourns_SRN8040TA
L203, | 1 | 22uH | L-Device-mainboard-rescue | Inductor_SMD:L_Vishay_IHLP-2525
P1, | 1 | Card Edge for HSEC8-160-01-S-DV-A-K-TR | Conn_02x60_Top_Bottom | SLI-Blank-Card:HSEC8-160-CARD-EDGE
Q1, Q4, Q5, | 3 | DMN100-7-F | IRLML2803TRPBF | mainboard:SOT-23
Q2, Q3, Q7, Q8, Q15, Q16, | 6 | MMDT5551-7-F | MBT2222ADW1T1-Transistor_BJT-mainboard-rescue | Package_TO_SOT_SMD:SOT-363_SC-70-6
Q6, | 1 | SMMBT2222AWT1G | MMBT2222AT | Package_TO_SOT_SMD:SOT-323_SC-70
Q11, | 1 | MMDT2907AQ-7-F | MMDT2907 | Package_TO_SOT_SMD:SOT-363_SC-70-6
Q12, Q13, Q18, Q19, | 4 | BSS138DWQ-7 | BSS138DWQ-7 | mainboard:BSS138DWQ-7
Q17, | 1 | FJV992FMTF | MMBT2907 | Package_TO_SOT_SMD:SOT-23
Q20, Q21, Q22, | 3 | IRF7404TRPBF | NDS8434 | Package_SO:SOIC-8_3.9x4.9mm_P1.27mm
Q200, Q201, Q202, Q203, | 4 | BC847BM3T5G | Q_NPN_BEC-Device-mainboard-rescue | Package_TO_SOT_SMD:SOT-723
Q204, Q209, Q215, Q222, | 4 | MMBT3906-7-F | Q_PNP_BEC-Device-mainboard-rescue | Package_TO_SOT_SMD:SOT-23
Q205, Q210, Q221, | 3 | MMBT4401-7-F | Q_NPN_BCE-Device-mainboard-rescue | Package_TO_SOT_SMD:SOT-23
Q206, Q208, | 2 | IRF7458 | IRF7458 | Package_SO:SOIC-8_3.9x4.9mm_P1.27mm
Q207, Q211, Q212, Q213, Q220, | 5 | IRF7404 | IRF7404-Transistor_FET-mainboard-rescue | Package_SO:SOIC-8_3.9x4.9mm_P1.27mm
R1, | 1 | 316K | R_US-Device-mainboard-rescue | Resistor_SMD:R_0603_1608Metric
R2, | 1 | 110K | R_US-Device-mainboard-rescue | Resistor_SMD:R_0603_1608Metric
R3, R4, R21, R24, R44, R45, R46, R52, R61, R62, R66, R67, R82, R83, R84, R85, | 16 | 10K | R_US-Device-mainboard-rescue | Resistor_SMD:R_0603_1608Metric
R5, R7, R25, R27, R28, R42, R43, R50, R51, R212, R230, R231, R235, R238, | 14 | 10k | R_US-Device-mainboard-rescue | Resistor_SMD:R_0603_1608Metric
R8, | 1 | 0.1 | R-US_R2512 | Resistor_SMD:R_2512_6332Metric
R13, R29, | 2 | 73.2K | R_US-Device-mainboard-rescue | Resistor_SMD:R_0603_1608Metric
R14, | 1 | 22.1K | R-US_R0603 | Resistor_SMD:R_0603_1608Metric
R15, R30, R49, R73, R74, R93, R94, | 7 | 100K | R_US-Device-mainboard-rescue | Resistor_SMD:R_0603_1608Metric
R22, R68, | 2 | 4.7K | R_US-Device-mainboard-rescue | Resistor_SMD:R_0603_1608Metric
R23, | 1 | 3.3K | R-US_R0603 | Resistor_SMD:R_0603_1608Metric
R26, R63, R64, R69, R70, R77, R78, | 7 | 1K | R_US-Device-mainboard-rescue | Resistor_SMD:R_0603_1608Metric
R32, R33, R60, R92, R213, R218, R250, | 7 | 4.7k | R_US-Device-mainboard-rescue | Resistor_SMD:R_0603_1608Metric
R34, | 1 | 5.23K | R_US-Device-mainboard-rescue | Resistor_SMD:R_0603_1608Metric
R35, | 1 | 30.1K | R_US-Device-mainboard-rescue | Resistor_SMD:R_0603_1608Metric
R36, | 1 | 3.16K | R_US-Device-mainboard-rescue | Resistor_SMD:R_0603_1608Metric
R37, R38, R214, R215, R216, R219, R220, R221, R225, R227, R229, R234, R239, R240, R248, R249, R252, R254, R259, R260, | 20 | 100k | R_US-Device-mainboard-rescue | Resistor_SMD:R_0603_1608Metric
R47, R75, R76, R95, R96, | 5 | 200K | R_US-Device-mainboard-rescue | Resistor_SMD:R_0603_1608Metric
R48, R53, R97, R98, R99, R101, R104, R107, R108, R109, | 10 | 0 | R_US-Device-mainboard-rescue | Resistor_SMD:R_0603_1608Metric
R71, R72, R86, R87, | 4 | 680 | R_US-Device-mainboard-rescue | Resistor_SMD:R_0603_1608Metric
R110, | 1 | 20K | R_US-Device-mainboard-rescue | Resistor_SMD:R_0603_1608Metric
R200, R211, | 2 | 10k | R_US-Device-mainboard-rescue | Resistor_SMD:R_0402_1005Metric
R201, | 1 | 1Meg | R_US-Device-mainboard-rescue | Resistor_SMD:R_0402_1005Metric
R202, R203, R204, R205, R206, R207, R208, R209, | 8 | 1.5k | R_US-Device-mainboard-rescue | Resistor_SMD:R_0402_1005Metric
R210, | 1 | DNP | R_US-Device-mainboard-rescue | Resistor_SMD:R_0402_1005Metric
R217, R247, | 2 | 2.2Meg | R_US-Device-mainboard-rescue | Resistor_SMD:R_0603_1608Metric
R224, R251, | 2 | 523k | R_US-Device-mainboard-rescue | Resistor_SMD:R_0603_1608Metric
R226, R253, | 2 | 3.3k | R_US-Device-mainboard-rescue | Resistor_SMD:R_0603_1608Metric
R228, R255, | 2 | 330k | R_US-Device-mainboard-rescue | Resistor_SMD:R_0603_1608Metric
R256, | 1 | 0.05 | R_US-Device-mainboard-rescue | Resistor_SMD:R_1206_3216Metric
R257, | 1 | 121k | R_US-Device-mainboard-rescue | Resistor_SMD:R_0603_1608Metric
R258, | 1 | 634k | R_US-Device-mainboard-rescue | Resistor_SMD:R_0603_1608Metric
R262, | 1 | 412k | R_US-Device-mainboard-rescue | Resistor_SMD:R_0603_1608Metric
SW1, | 1 | KMR231NG LFS | SWITCH_SMT4.6X2.8 | mainboard:BTN_KMR2_4.6X2.8
SW200, | 1 | SW_Push_SPST | SW_Push-Switch-mainboard-rescue | SLI-Blank-Card:EVQP7C01P
U1, | 1 | MAX706RESA | MAX708RESA-T | Package_SO:SO-8_3.9x4.9mm_P1.27mm
U2, | 1 | ATSAMD51N20A-AUT | ATSAMD51N20A-AUT | Package_QFP:TQFP-100_14x14mm_P0.5mm
U4, | 1 | ADM1176-1ARMZ-R7 | ADM1176-1ARMZ-R7 | mainboard:ADM1176-1ARMZ-R7
U5, | 1 | TPS54226PWPRPWP14_2P31X2P46-L | TPS54226PWPRPWP14_2P31X2P46-L | mainboard:PWP14_2P31X2P46-L
U8, | 1 | MR25H40MDF | MR25H40MDF | mainboard:SON127P600X500X90-9N
U13, | 1 | EP2W+ | EP2W+ | mainboard:QFN32-5X5MM
U14, | 1 | S1216V8 | S1216V8 | mainboard:S1216_24PIN_PACKAGE
U15, U20, | 2 | RFM9xBreakout | RFM9xBreakout | RF_Module:HOPERF_RFM9XW_SMD
U16, | 1 | PE014006 | PE014005 | mainboard:RELAY_PE014006
U17, | 1 | BQ25883RGER | BQ25883RGER | mainboard:QFN50P400X400X100-25N-D
U23, U24, | 2 | RFM98PW | RFM98PW | mainboard:RFM95PW
U200, | 1 | AP2161W | AP2161W-Power_Management-mainboard-rescue | Package_TO_SOT_SMD:SOT-23-5
U201, | 1 | PCA9543APW,118 | PCA9543APW,118 | Package_SO:TSSOP-14_4.4x5mm_P0.65mm | 2-channel I2C-bus multiplexer with interrupt logic, TSSOP-14
U203, U210, | 2 | TPS63070 | TPS63070 | mainboard-SLI:TPS63070RNMR
U204, U207, | 2 | IAM-20380 | IAM-20380 | mainboard-SLI:IAM-20380
U205, U208, | 2 | MMC5983MA | MMC5983MA | mainboard-SLI:MMC5983MA
U206, U209, | 2 | MXC6655XA | MXC6655XA | mainboard-SLI:MXC6655XA
U211, | 1 | ‎LT3652HVEMSE#TRPBF‎ | LTC3652HV | Package_SO:MSOP-12-1EP_3x4mm_P0.65mm_EP1.65x2.85mm_ThermalVias
Y1, | 1 | 32.768kHz | Crystal-Device-mainboard-rescue | Crystal:Crystal_SMD_3215-2Pin_3.2x1.5mm
Z200, Z201, | 2 | CG0402MLU-05G | Varistor-Device-mainboard-rescue | Capacitor_SMD:C_0402_1005Metric
