Sierra-Lobo/mainboard-hardware/revC-fm/mainboard.dxf

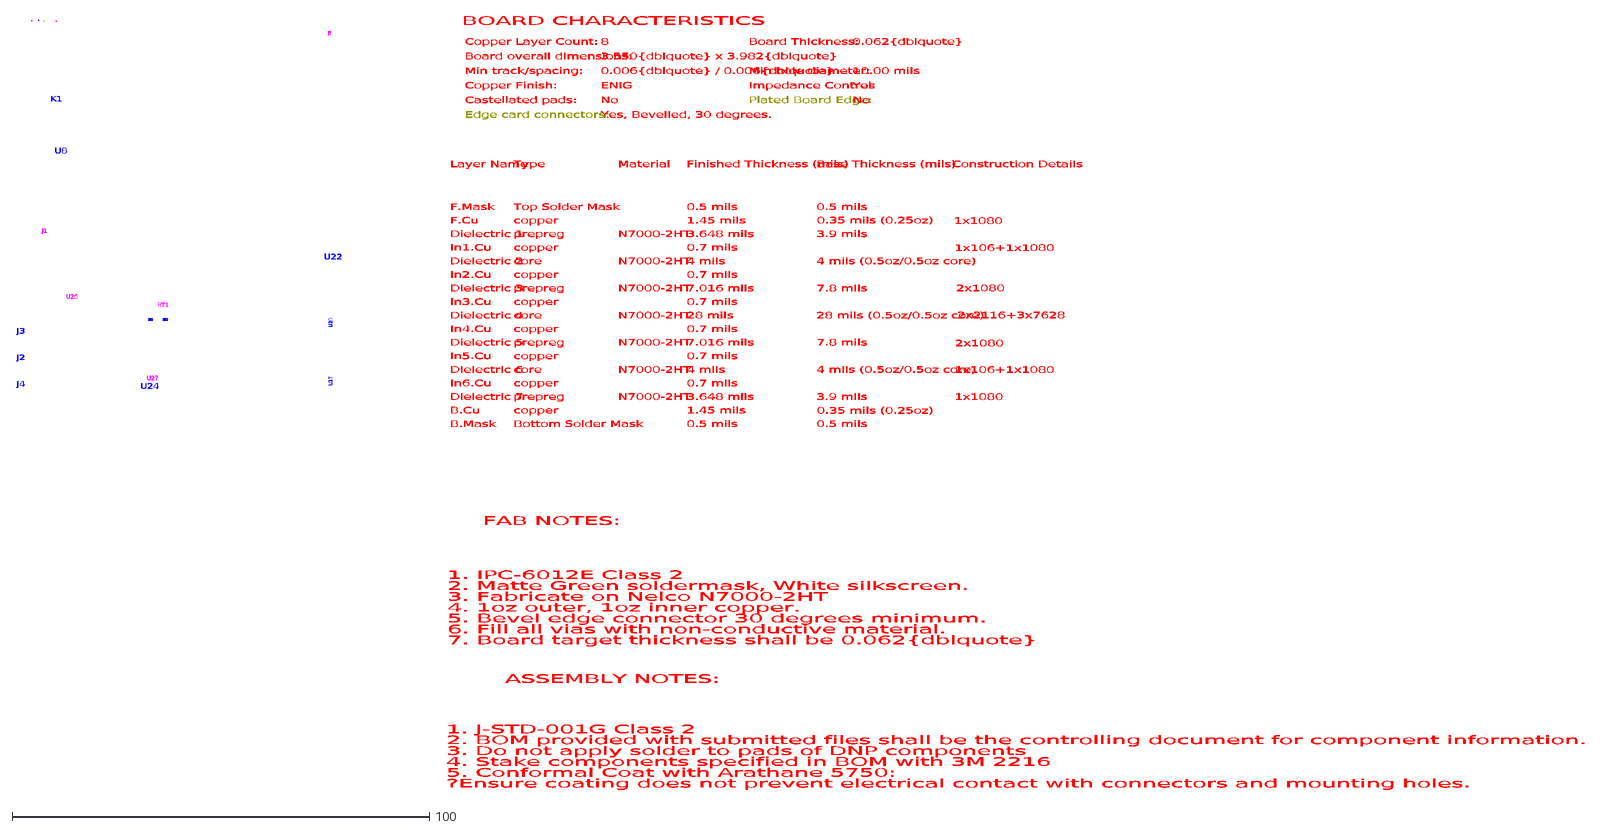
[picture p11: CAD file, 2023-06-16]
revC-fm/mainboard.dxf
copper
2x2116+3x7628
0.5 mils
8
Copper Finish:
Top Solder Mask
core
prepreg
28 mils
Bottom Solder Mask
Material
7.8 mils
Min hole diameter:
In6.Cu
1x1080
Dielectric 3
0.006{dblquote} / 0.006{dblquote}
Impedance Control:
FAB NOTES:
Min track/spacing:
1x106+1x1080
3.648 mils
7.016 mils
0.35 mils (0.25oz)
Type
In3.Cu
In2.Cu
In1.Cu
0.7 mils
Dielectric 6
Layer Name
N7000-2HT
ASSEMBLY NOTES:
3.9 mils
28 mils (0.5oz/0.5oz core)
4 mils (0.5oz/0.5oz core)
Finished Thickness (mils)
4 mils
2x1080
Plated Board Edge:
Castellated pads:
F.Cu
Yes
In4.Cu
Dielectric 4
Construction Details
Yes, Bevelled, 30 degrees.
Board Thickness:
B.Cu
No
Board overall dimensions:
1.45 mils
Dielectric 2
10.00 mils
Dielectric 7
1. IPC-6012E Class 2
2. Matte Green soldermask, White silkscreen.
3. Fabricate on Nelco N7000-2HT
4. 1oz outer, 1oz inner copper.
5. Bevel edge connector 30 degrees minimum.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
