Sierra-Lobo/mainboard-hardware/revC-fm/docs/mainboard-revC-assembly-bot.png

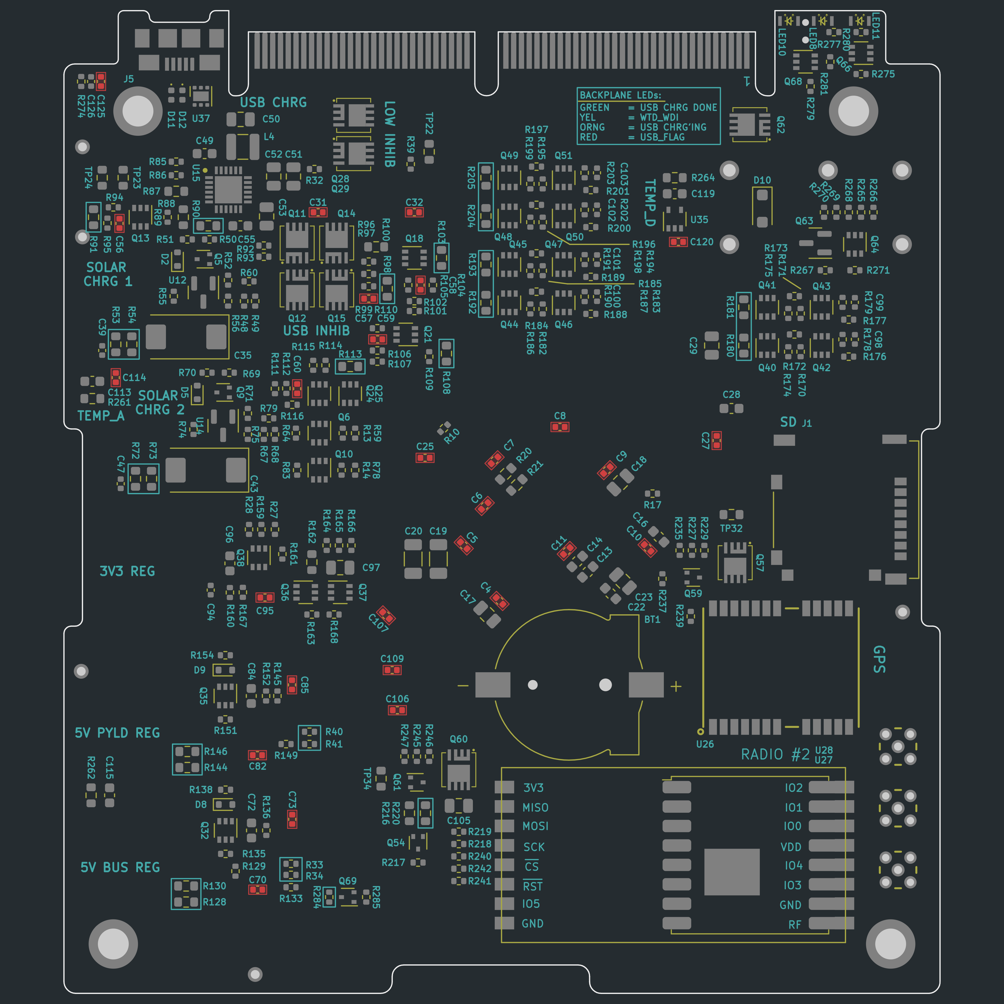
revC-fm/docs/mainboard-revC-assembly-bot.png
