Sierra-Lobo/mainboard-hardware/revC-fm/docs/mainboard-revC-assembly-top.png

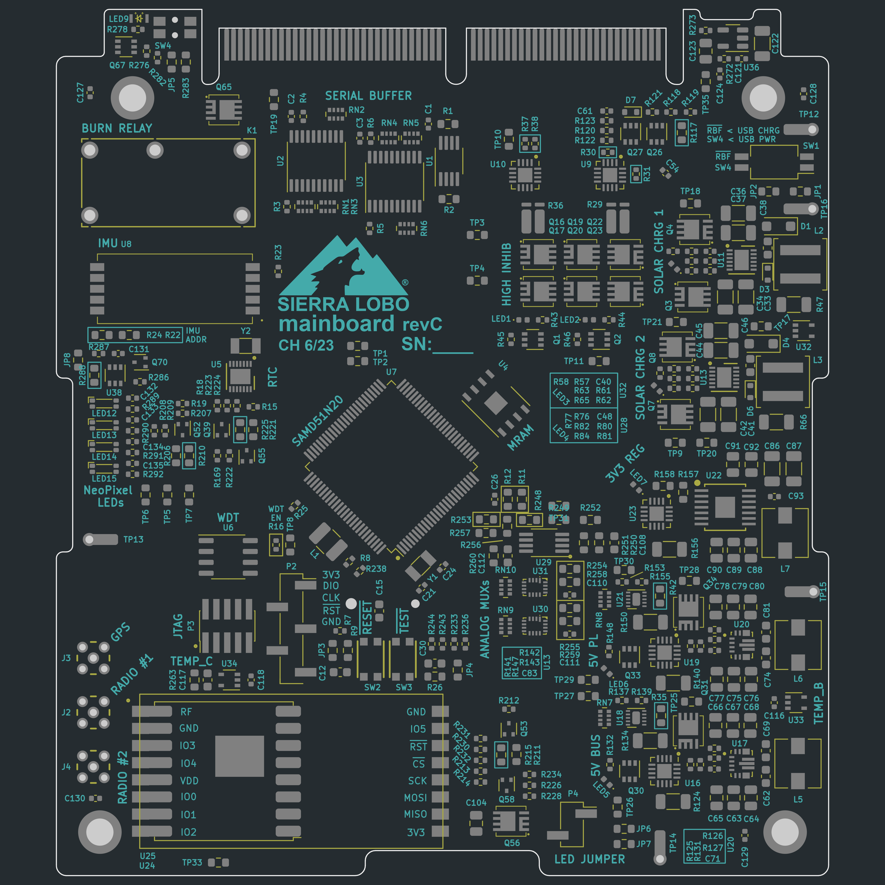
revC-fm/docs/mainboard-revC-assembly-top.png
