Sierra-Lobo/mainboard-hardware/(threads)

Thread 8 (2023-08-30):

SW2, SW3 footprint error

cadenhillis, 2023-08-30:

Thread 10 (2024-01-25):

radio1 transmit bug

cadenhillis, 2024-01-25:

cadenhillis, 2024-01-31:
this ended up being an issue with the power supply to the board.

Thread 11 (2024-01-25):

input buffer for SPI MOSI

cadenhillis, 2024-01-25:
input buffer for SPI MOSI inhibits local SPI bus by pulling MOSI low.

change for next rev, current fix is to lift the pin.

Thread 9 (2024-01-25):

OCP switch inrush issue diagnosis

cadenhillis, 2024-01-25:

Thread 12 (2024-02-20):

RBF inhibit schematic error

cadenhillis, 2024-02-20:
