Sierra-Lobo/mainboard-hardware/revA-proto/pdf/crude block diagram.pdf

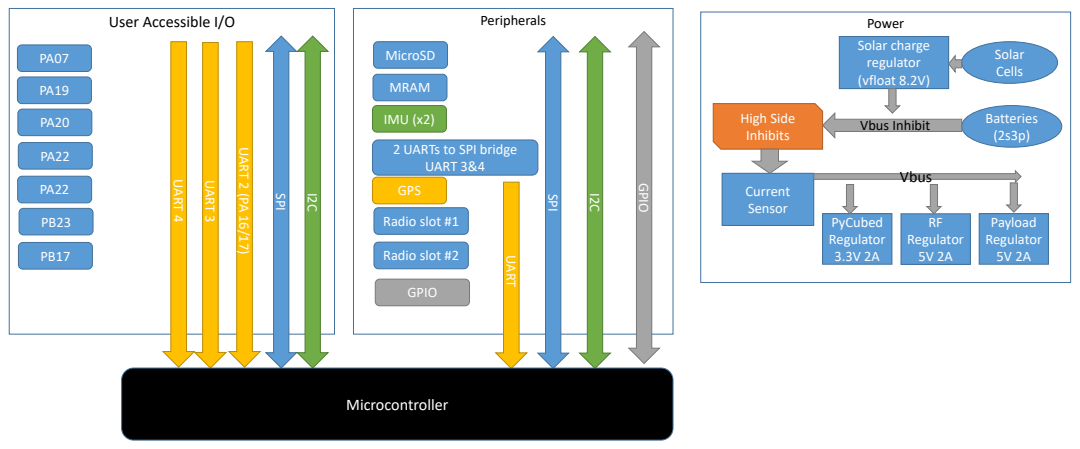
[picture p14: page 1]
Power; Solar Cells; Batteries (2s3p); Solar charge regulator (vfloat 8.2V); Current Sensor; High Side; Inhibits; Vbus Inhibit; Vbus; PyCubed Regulator 3.3V 2A; RF Regulator 5V 2A; Payload Regulator 5V 2A; Peripherals; MicroSD; MRAM; IMU (x2); Radio slot #1; Radio slot #2; SPI; UART; User Accessible I/O; UART 2 (PA 16/17); UART 4; UART 3; Microcontroller; GPIO

2 UARTs to SPI bridge
UART 3&4
GPS
