Sierra-Lobo/mainboard-hardware/revA-proto/pdf/mainboard.pdf

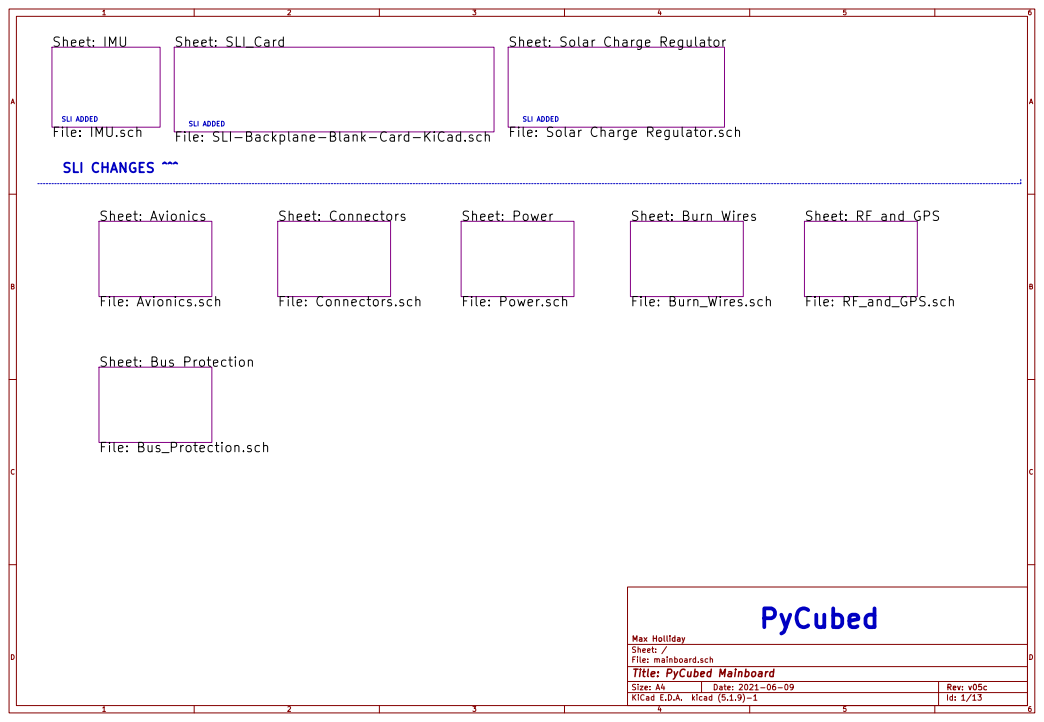
[picture p15: page 1]

Sheet: Solar Charge Regulator

File: SLI-Backplane-Blank-Card-KiCad.sch

File: Solar Charge Regulator.sch

Sheet: RF and GPS

File: mainboard.sch Sheet: / Max Holliday

Id: 1/13 Title: PyCubed Mainboard

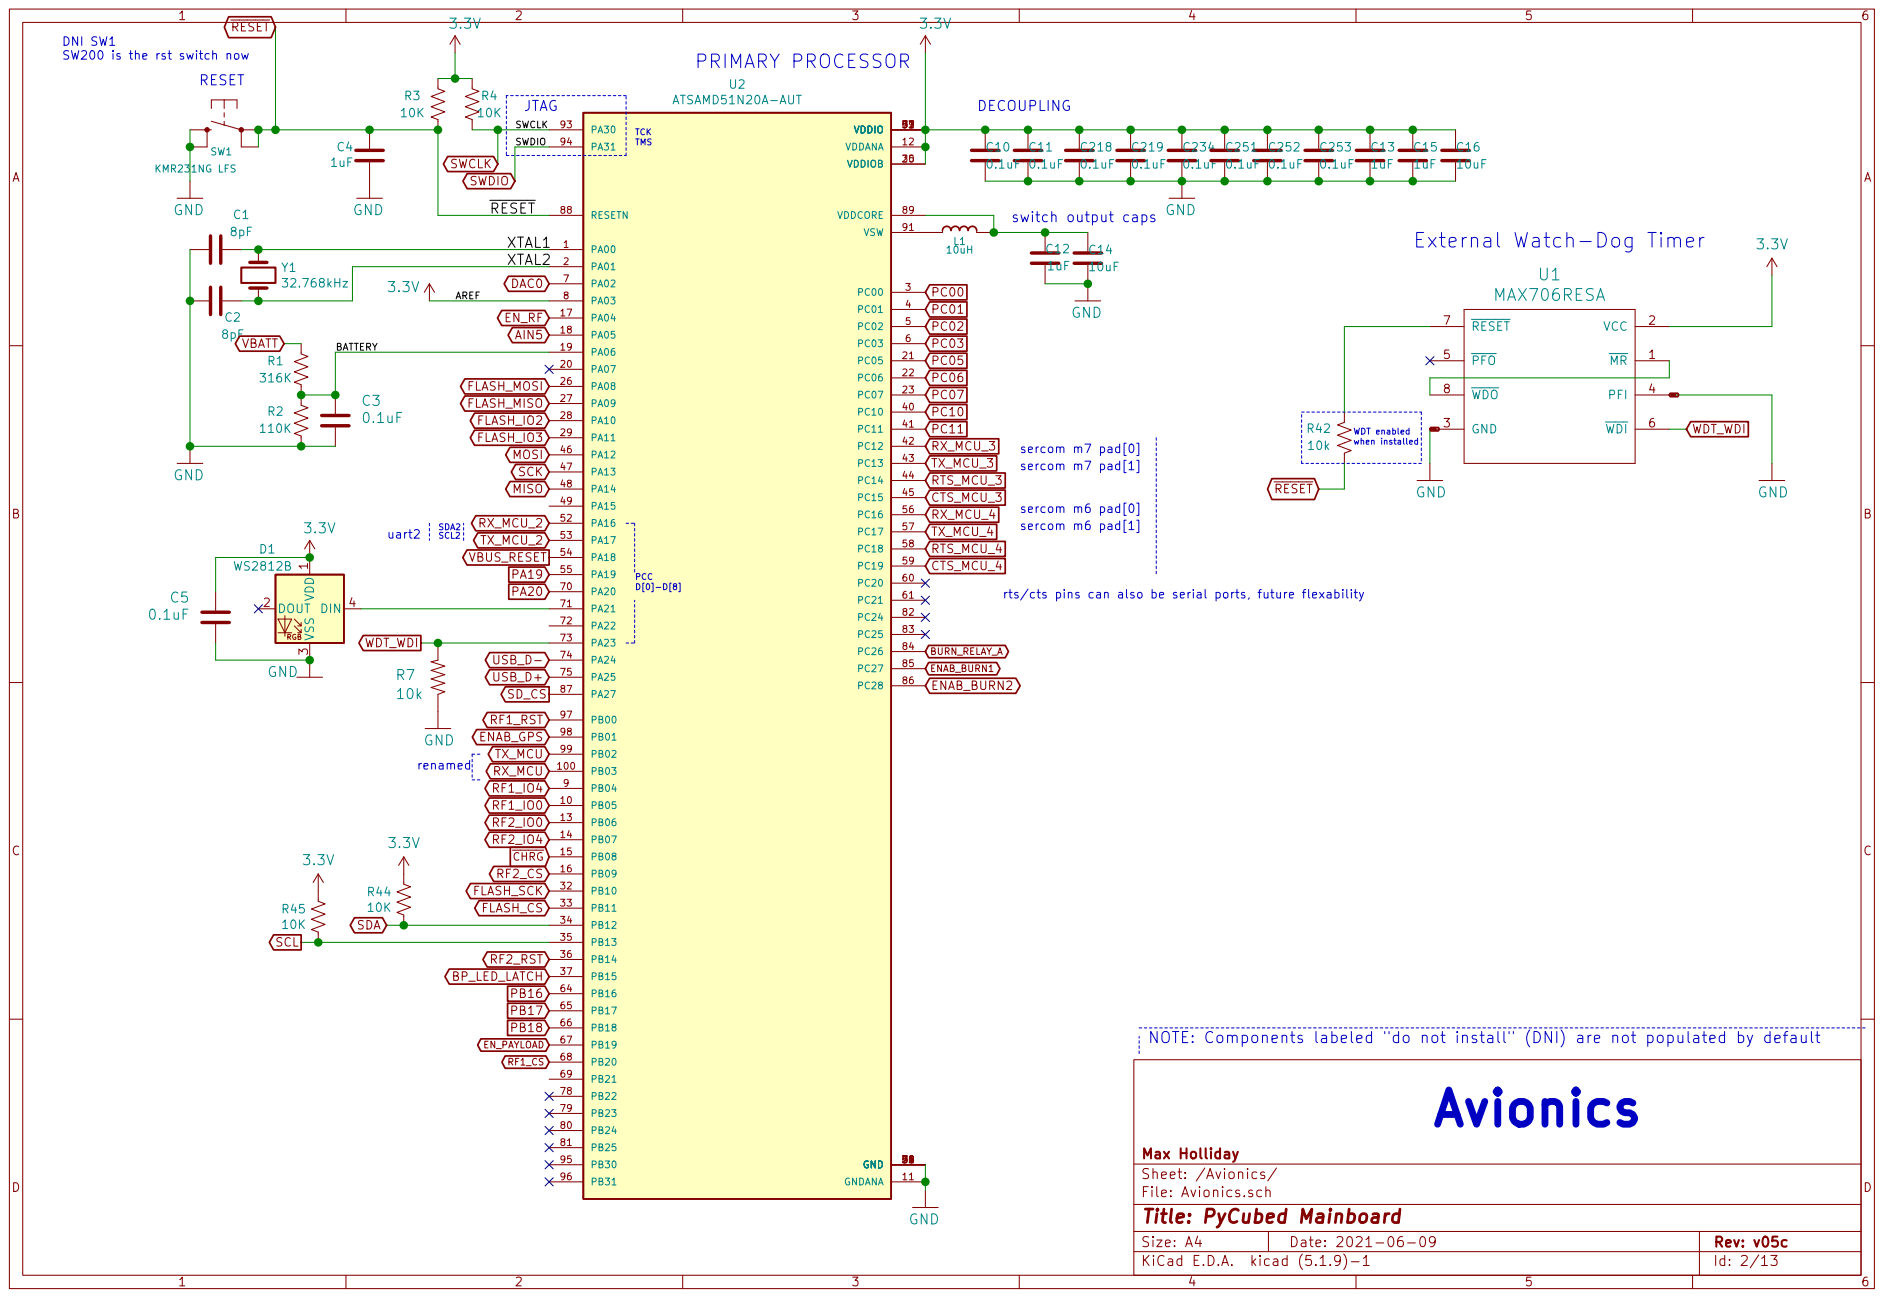
[picture p16: page 2]

switch output caps DNI SW1 SW200 is the rst switch now

External Watch-Dog Timer DECOUPLING

rts/cts pins can also be serial ports, future flexability

File: Avionics.sch Sheet: /Avionics/ Max Holliday

Id: 2/13 Title: PyCubed Mainboard

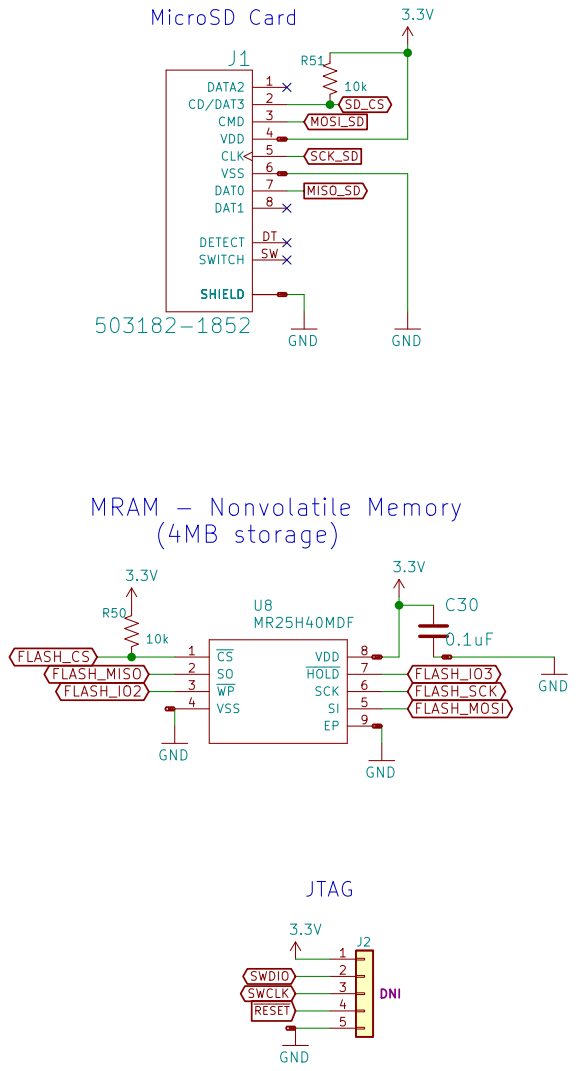
[picture p17: page 3]

NOTE: Components labeled "do not install" (DNI) are not populated by default

File: Connectors.sch Sheet: /Connectors/ Max Holliday GND

Id: 3/13 Title: PyCubed Mainboard

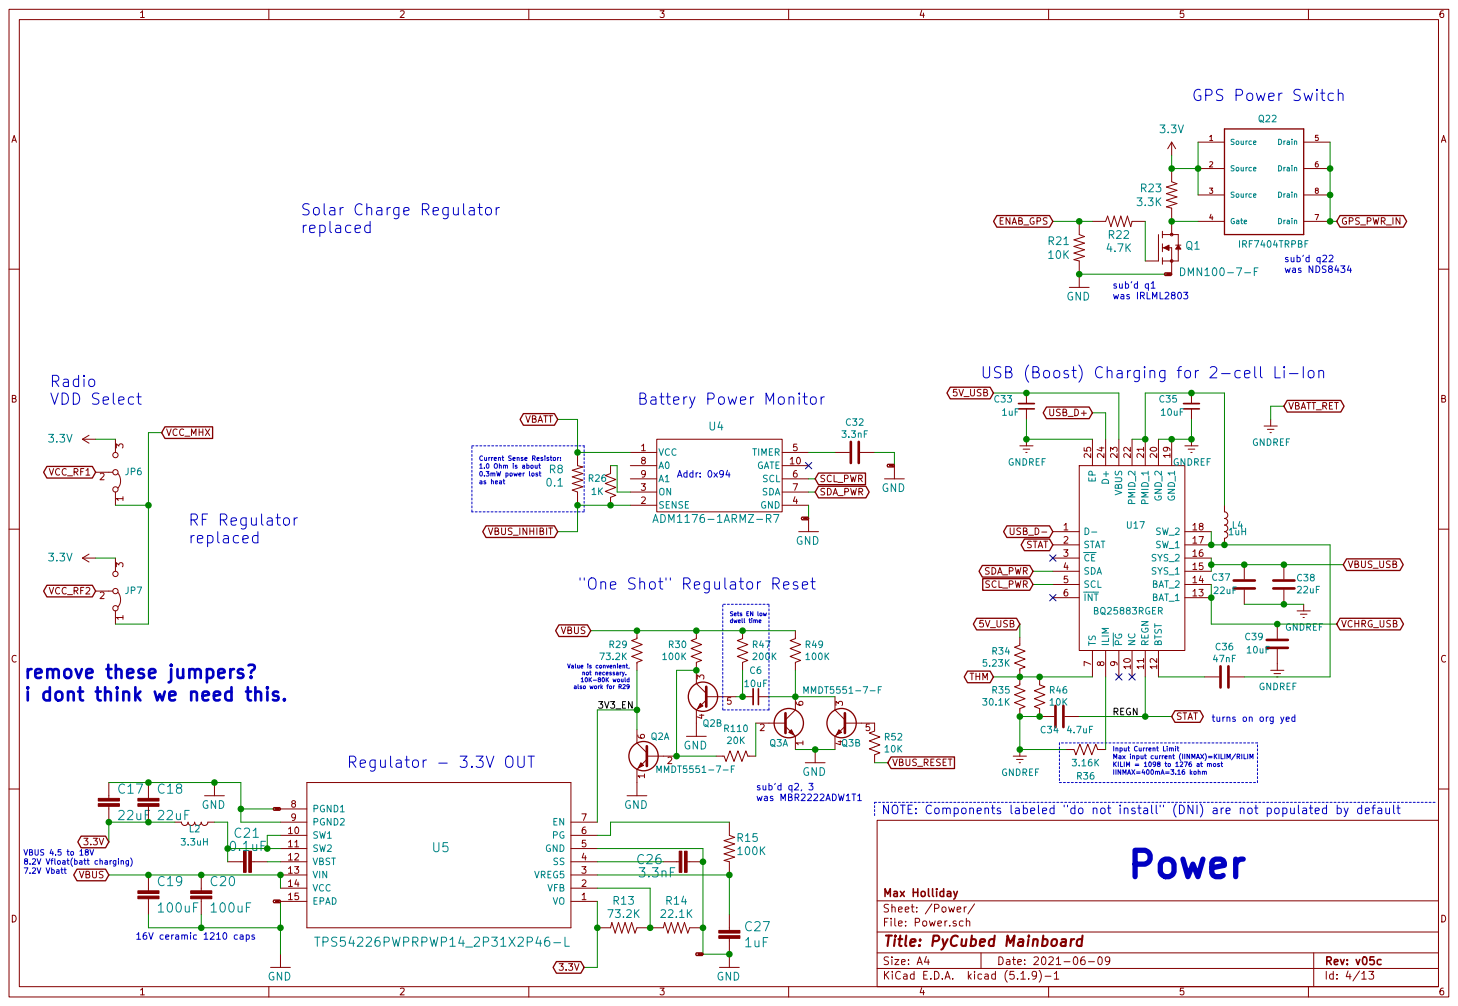
[picture p18: page 4]

sub'd q22 was NDS8434 USB (Boost) Charging for 2-cell Li-Ion

IINMAX=400mA=3.16 kohm RF Regulator
replaced

"One Shot" Regulator Reset

dwell time Regulator - 3.3V OUT

5V_USB
File: Power.sch Sheet: /Power/ Max Holliday R52

remove these jumpers?
i dont think we need this. VBUS 4.5 to 18V

Value is convenient, not necessary. 10K-80K would

turns on org yed

Input Current Limit Max input current (IINMAX)=KILIM/RILIM

KILIM = 1098 to 1276 at most

Id: 4/13 Title: PyCubed Mainboard

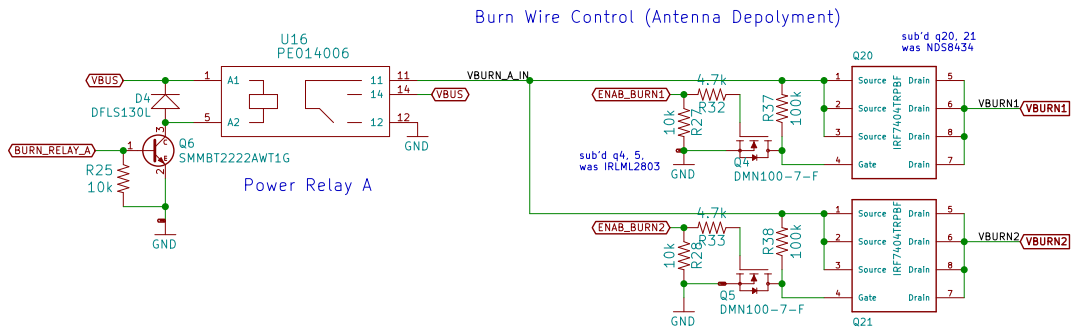
[picture p19: page 5]

Burn Wire Control (Antenna Depolyment)

sub'd q20, 21 was NDS8434 NOTE: Components labeled "do not install" (DNI) are not populated by default

File: Burn_Wires.sch Sheet: /Burn Wires/ Max Holliday

Id: 5/13 Title: PyCubed Mainboard

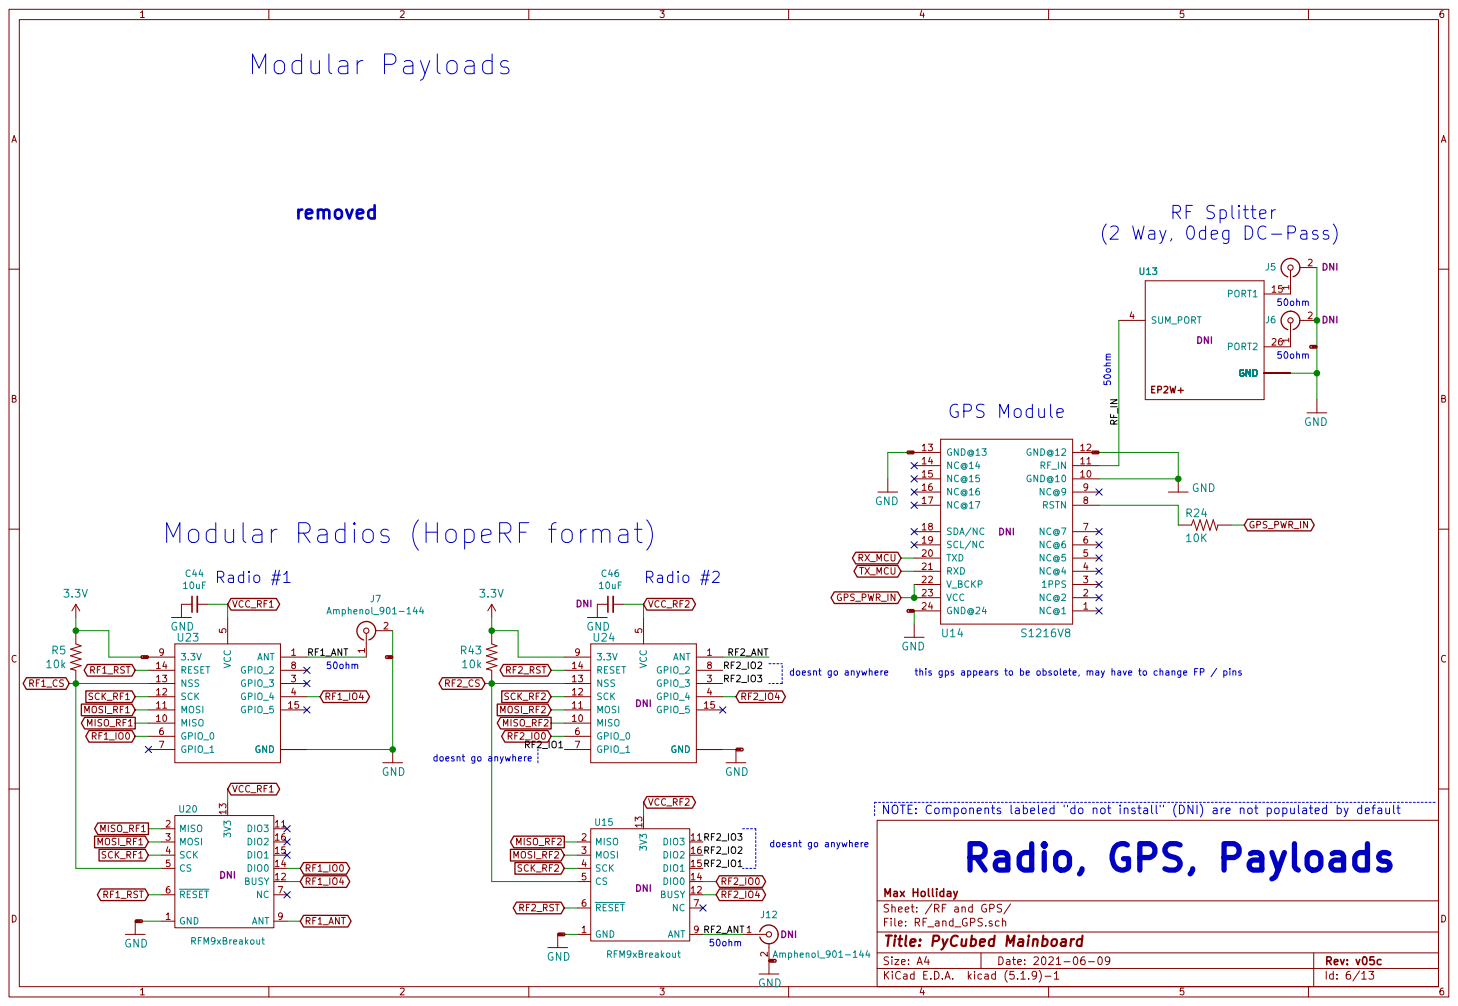
[picture p20: page 6]

File: RF_and_GPS.sch Sheet: /RF and GPS/ Max Holliday GND

Modular Radios (HopeRF format)

5 ANT 1 MISO 10 MOSI 11 SCK 12 NSS 13 RESET 14 GPIO_5 15 GND GPIO_3 3 GPIO_4 4 GPIO_0 6 GPIO_1 7 GPIO_2 8

NOTE: Components labeled "do not install" (DNI) are not populated by default
Radio, GPS, Payloads

Id: 6/13 Title: PyCubed Mainboard

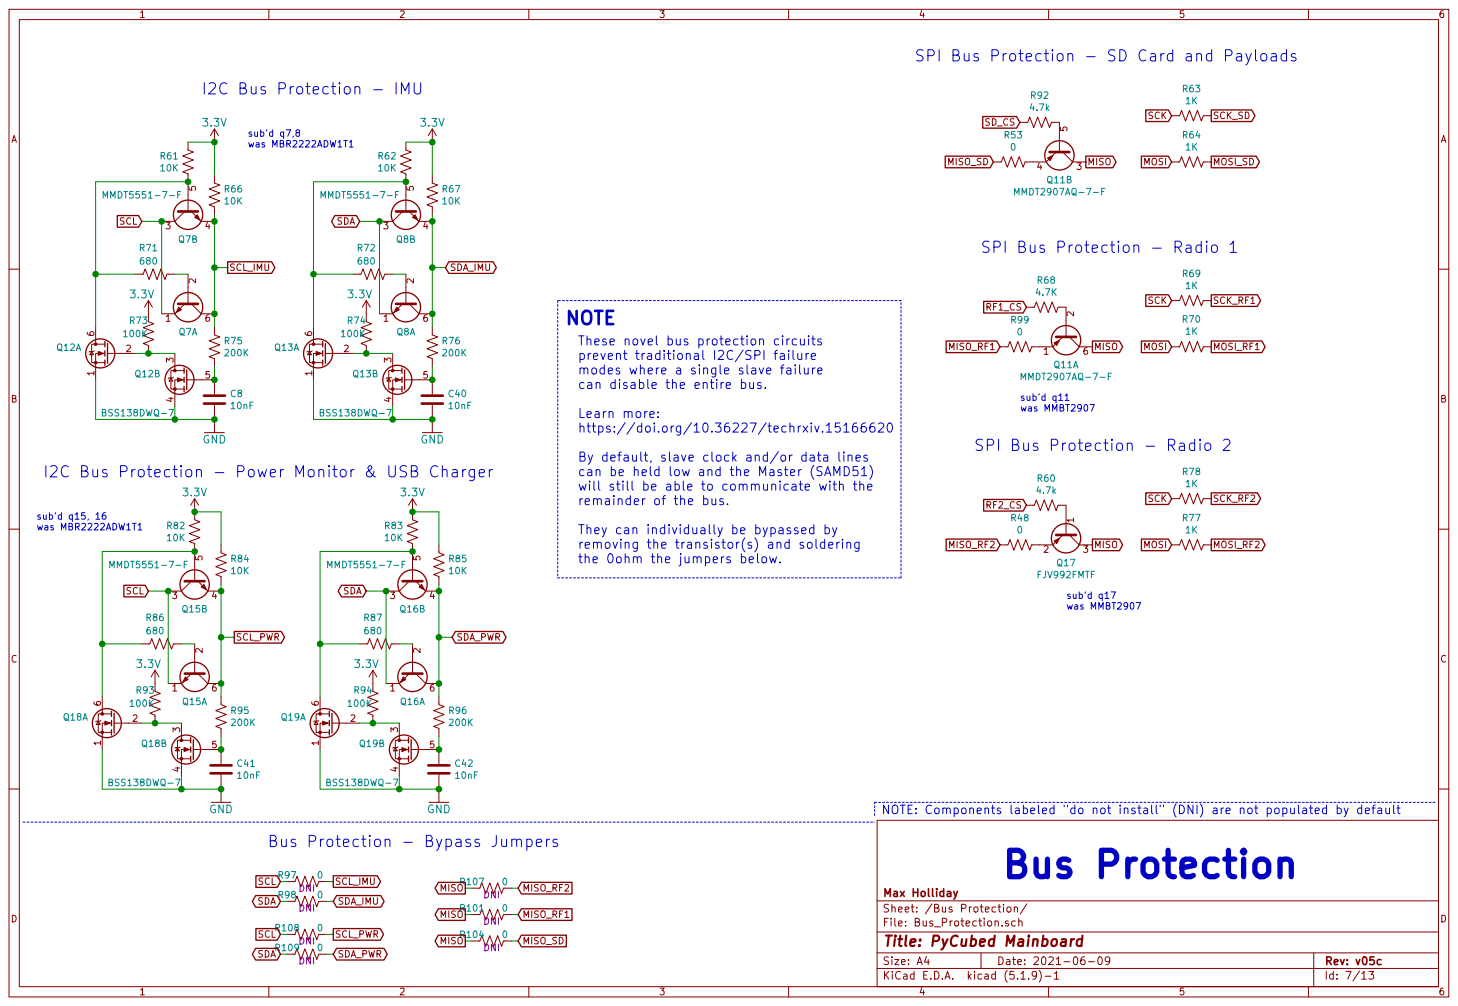
[picture p21: page 7]

SPI Bus Protection - SD Card and Payloads

SPI Bus Protection - Radio 1

prevent traditional I2C/SPI failure
modes where a single slave failure
can disable the entire bus.

Learn more:
https://doi.org/10.36227/techrxiv.15166620

SPI Bus Protection - Radio 2

By default, slave clock and/or data lines
can be held low and the Master (SAMD51)
will still be able to communicate with the
remainder of the bus.

I2C Bus Protection - Power Monitor & USB Charger

They can individually be bypassed by
removing the transistor(s) and soldering
the 0ohm the jumpers below.

NOTE: Components labeled "do not install" (DNI) are not populated by default

SCLBus Protection - Bypass Jumpers

File: Bus_Protection.sch Sheet: /Bus Protection/ Max Holliday

Id: 7/13 Title: PyCubed Mainboard

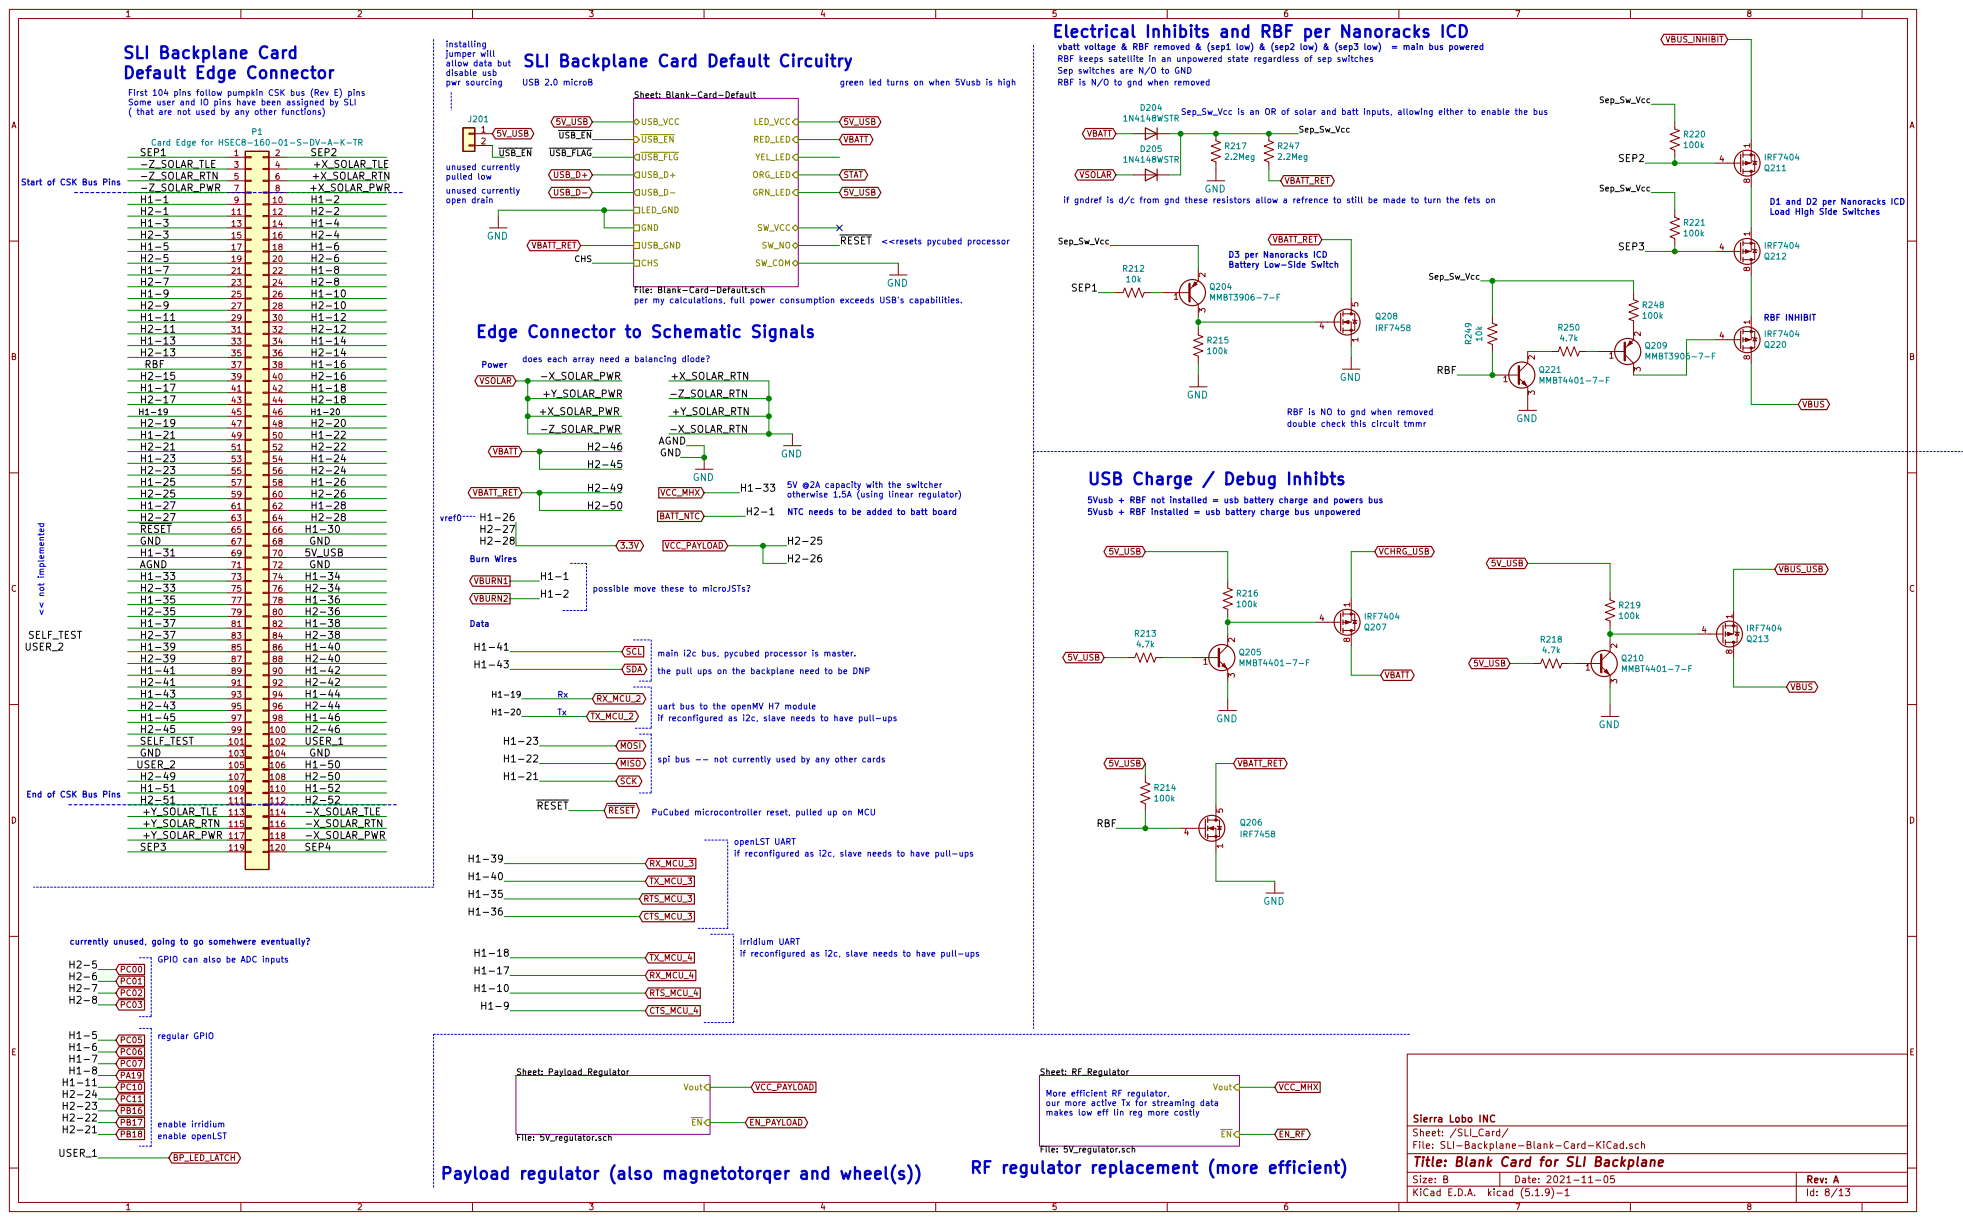
[picture p22: page 8]

Electrical Inhibits and RBF per Nanoracks ICD

installing
jumper will allow data but disable usb pwr sourcing

vbatt voltage & RBF removed & (sep1 low) & (sep2 low) & (sep3 low) = main bus powered
RBF keeps satellite in an unpowered state regardless of sep switches
Sep switches are N/O to GND
RBF is N/O to gnd when removed

SLI Backplane Card Default Circuitry

green led turns on when 5Vusb is high
LED_VCC GRN_LED

First 104 pins follow pumpkin CSK bus (Rev E) pins
Some user and IO pins have been assigned by SLI
( that are not used by any other functions)
H2-34 H1-36 H2-36 H2-2 +X_SOLAR_RTN

Sheet: Blank-Card-Default File: Blank-Card-Default.sch USB_VCC

Sep_Sw_Vcc is an OR of solar and batt inputs, allowing either to enable the bus

Start of CSK Bus Pins

if gndref is d/c from gnd these resistors allow a refrence to still be made to turn the fets on

D1 and D2 per Nanoracks ICD
Load High Side Switches

D3 per Nanoracks ICD
Battery Low-Side Switch

Edge Connector to Schematic Signals

USB Charge / Debug Inhibts

5V @2A capacity with the switcher
otherwise 1.5A (using linear regulator)
NTC needs to be added to batt board

5Vusb + RBF not installed = usb battery charge and powers bus
5Vusb + RBF installed = usb battery charge bus unpowered

main i2c bus, pycubed processor is master. << not implemented

possible move these to microJSTs?

the pull ups on the backplane need to be DNP

uart bus to the openMV H7 module
if reconfigured as i2c, slave needs to have pull-ups

spi bus -- not currently used by any other cards

End of CSK Bus Pins

PuCubed microcontroller reset, pulled up on MCU

openLST UART

currently unused, going to go somehwere eventually?

Irridium UART

GPIO can also be ADC inputs

Sheet: RF_Regulator
More efficient RF regulator,
our more active Tx for streaming data
makes low eff lin reg more costly

Sheet: /SLI_Card/ Sierra Lobo INC

File: SLI-Backplane-Blank-Card-KiCad.sch
Id: 8/13 Title: Blank Card for SLI Backplane

RF regulator replacement (more efficient)

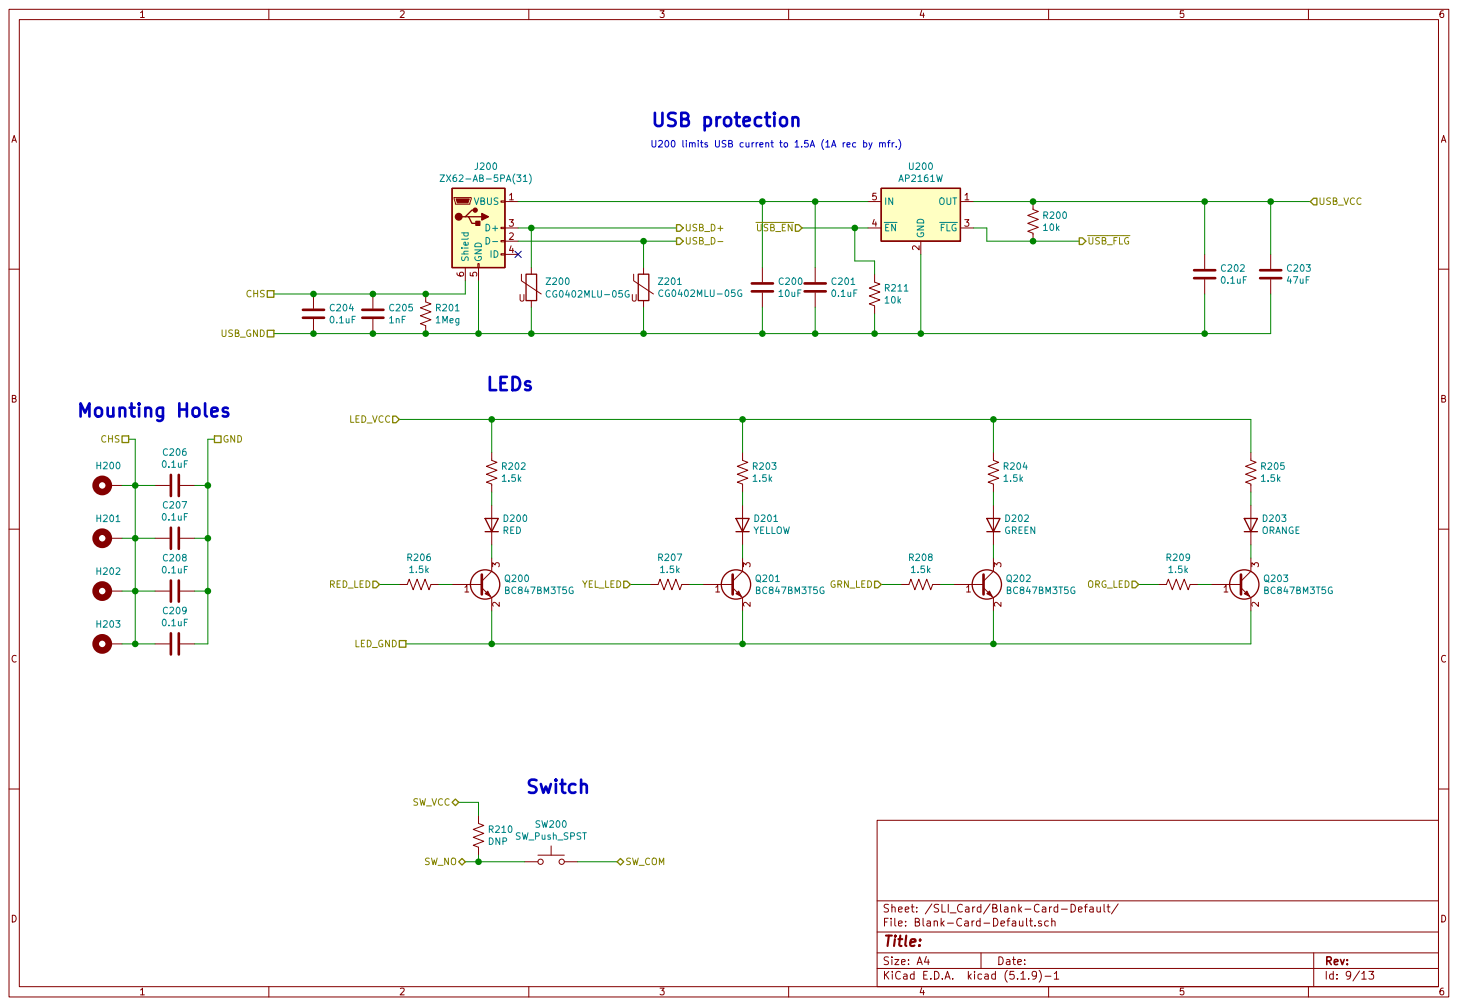
[picture p23: page 9]

U200 limits USB current to 1.5A (1A rec by mfr.)

Id: 9/13 Title: File: Blank-Card-Default.sch Sheet: /SLI_Card/Blank-Card-Default/

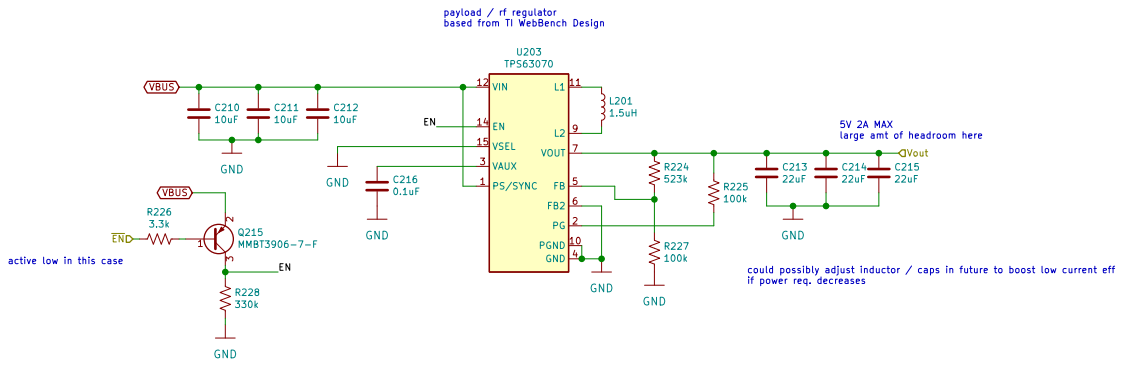
[picture p24: page 10]

payload / rf regulator
based from TI WebBench Design
10uF GND

large amt of headroom here

active low in this case

could possibly adjust inductor / caps in future to boost low current eff
if power req. decreases

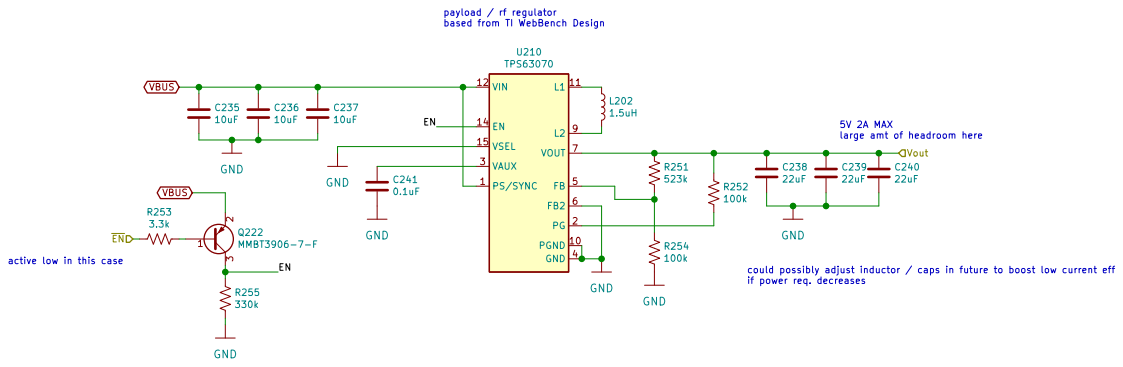
[picture p25: page 11]

payload / rf regulator
based from TI WebBench Design
10uF GND

large amt of headroom here

active low in this case

could possibly adjust inductor / caps in future to boost low current eff
if power req. decreases

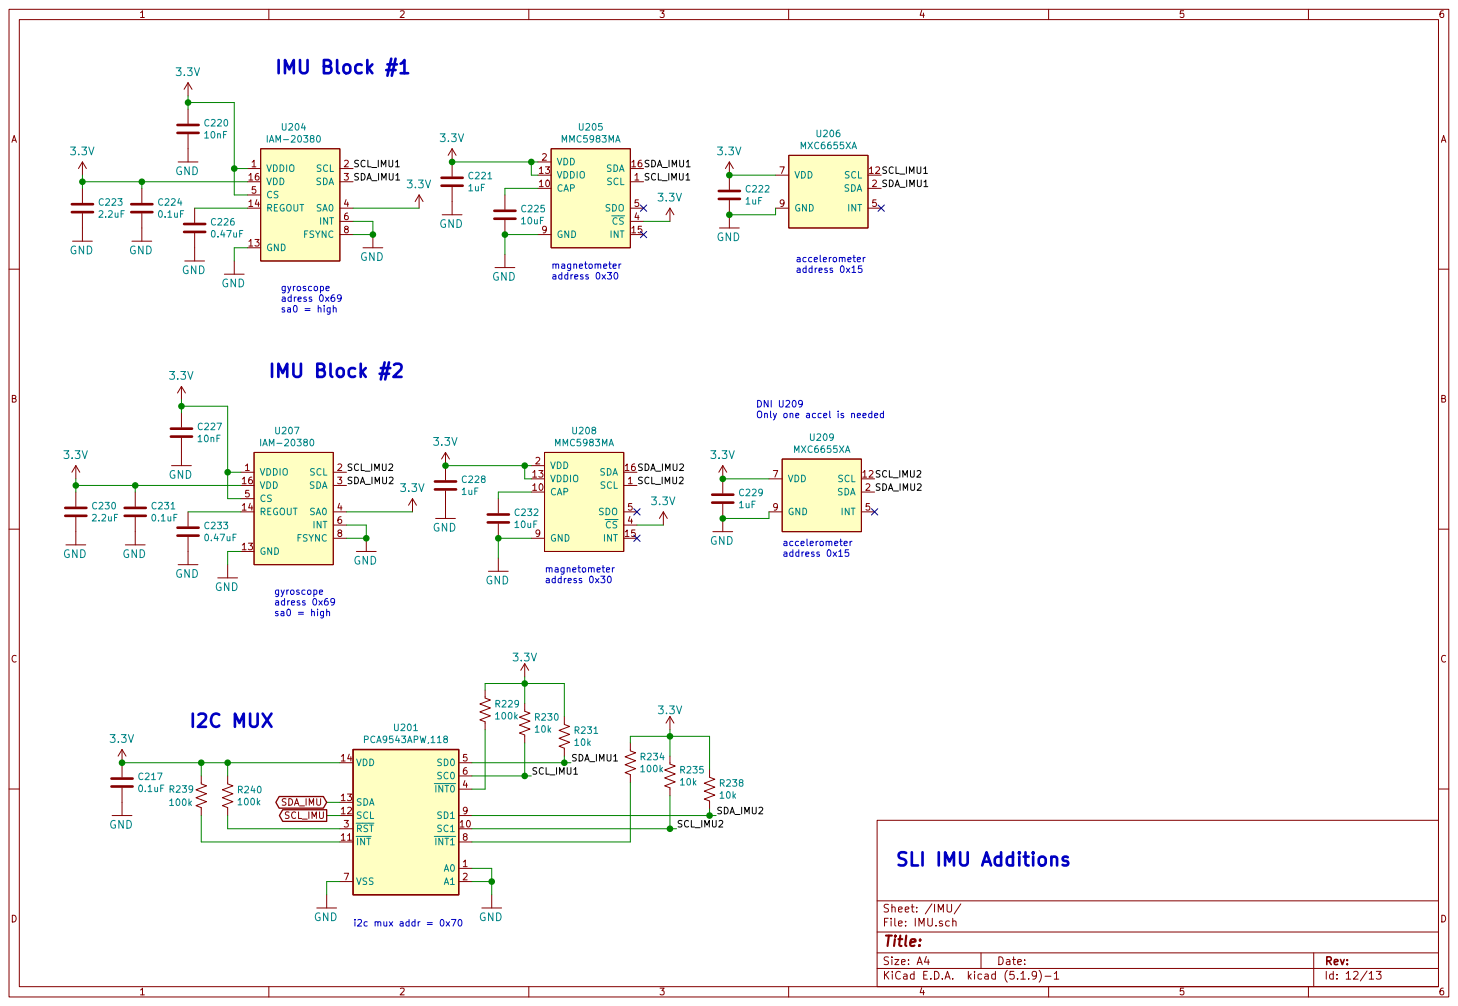
[picture p26: page 12]

accelerometer address 0x15 IMU Block #1
IAM-20380 GND
0.47uF GND GND

Id: 12/13 Title: File: IMU.sch Sheet: /IMU/

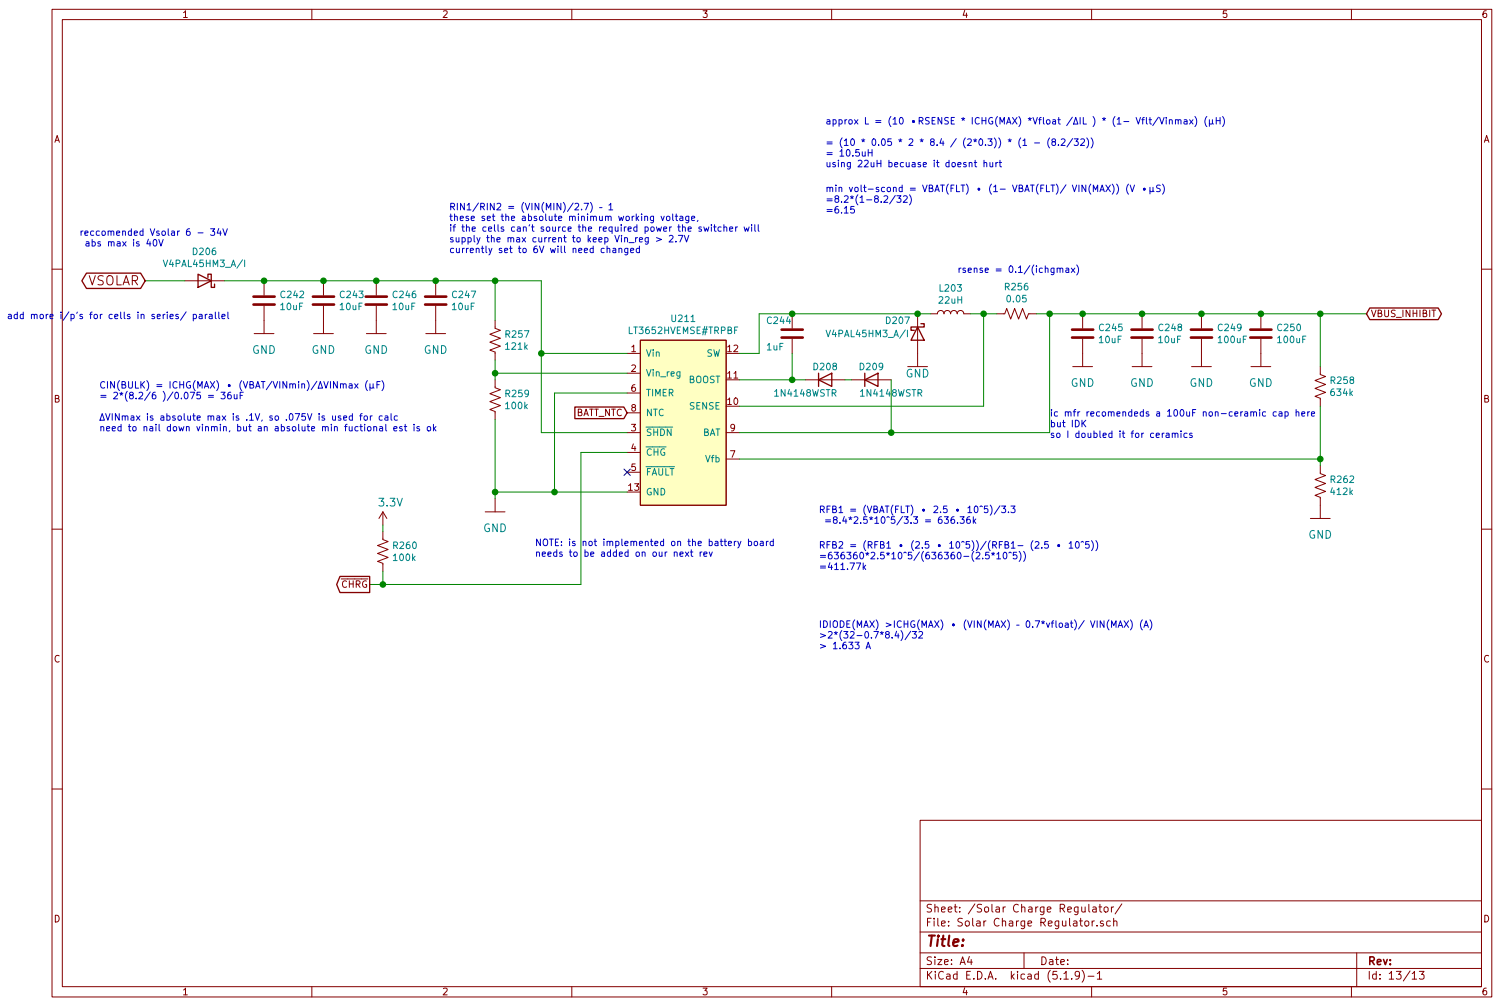
[picture p27: page 13]

so I doubled it for ceramics approx L = (10 RSENSE * ICHG(MAX) *Vfloat /IL ) * (1- Vflt/Vinmax) (µH)
=8.2*(1-8.2/32) =6.15 RFB1 = (VBAT(FLT) 2.5 10^5)/3.3

using 22uH becuase it doesnt hurt

min volt-scond = VBAT(FLT) (1 VBAT(FLT)/ VIN(MAX)) (V µS)

these set the absolute minimum working voltage,
if the cells can't source the required power the switcher will
supply the max current to keep Vin_reg > 2.7V
currently set to 6V will need changed

reccomended Vsolar 6 - 34V
abs max is 40V CIN(BULK) = ICHG(MAX) (VBAT/VINmin)/VINmax (µF)

add more i/p's for cells in series/ parallel

ic mfr recomendeds a 100uF non-ceramic cap here
but IDK

NOTE: is not implemented on the battery board
needs to be added on our next rev

IDIODE(MAX) >ICHG(MAX) (VIN(MAX) 0.7*vfloat)/ VIN(MAX) (A)

Sheet: /Solar Charge Regulator/
File: Solar Charge Regulator.sch
Id: 13/13 Title:
