Sierra-Lobo/mainboard-hardware/revC-fm/docs/stackup/sierra_circuit_stack.pdf

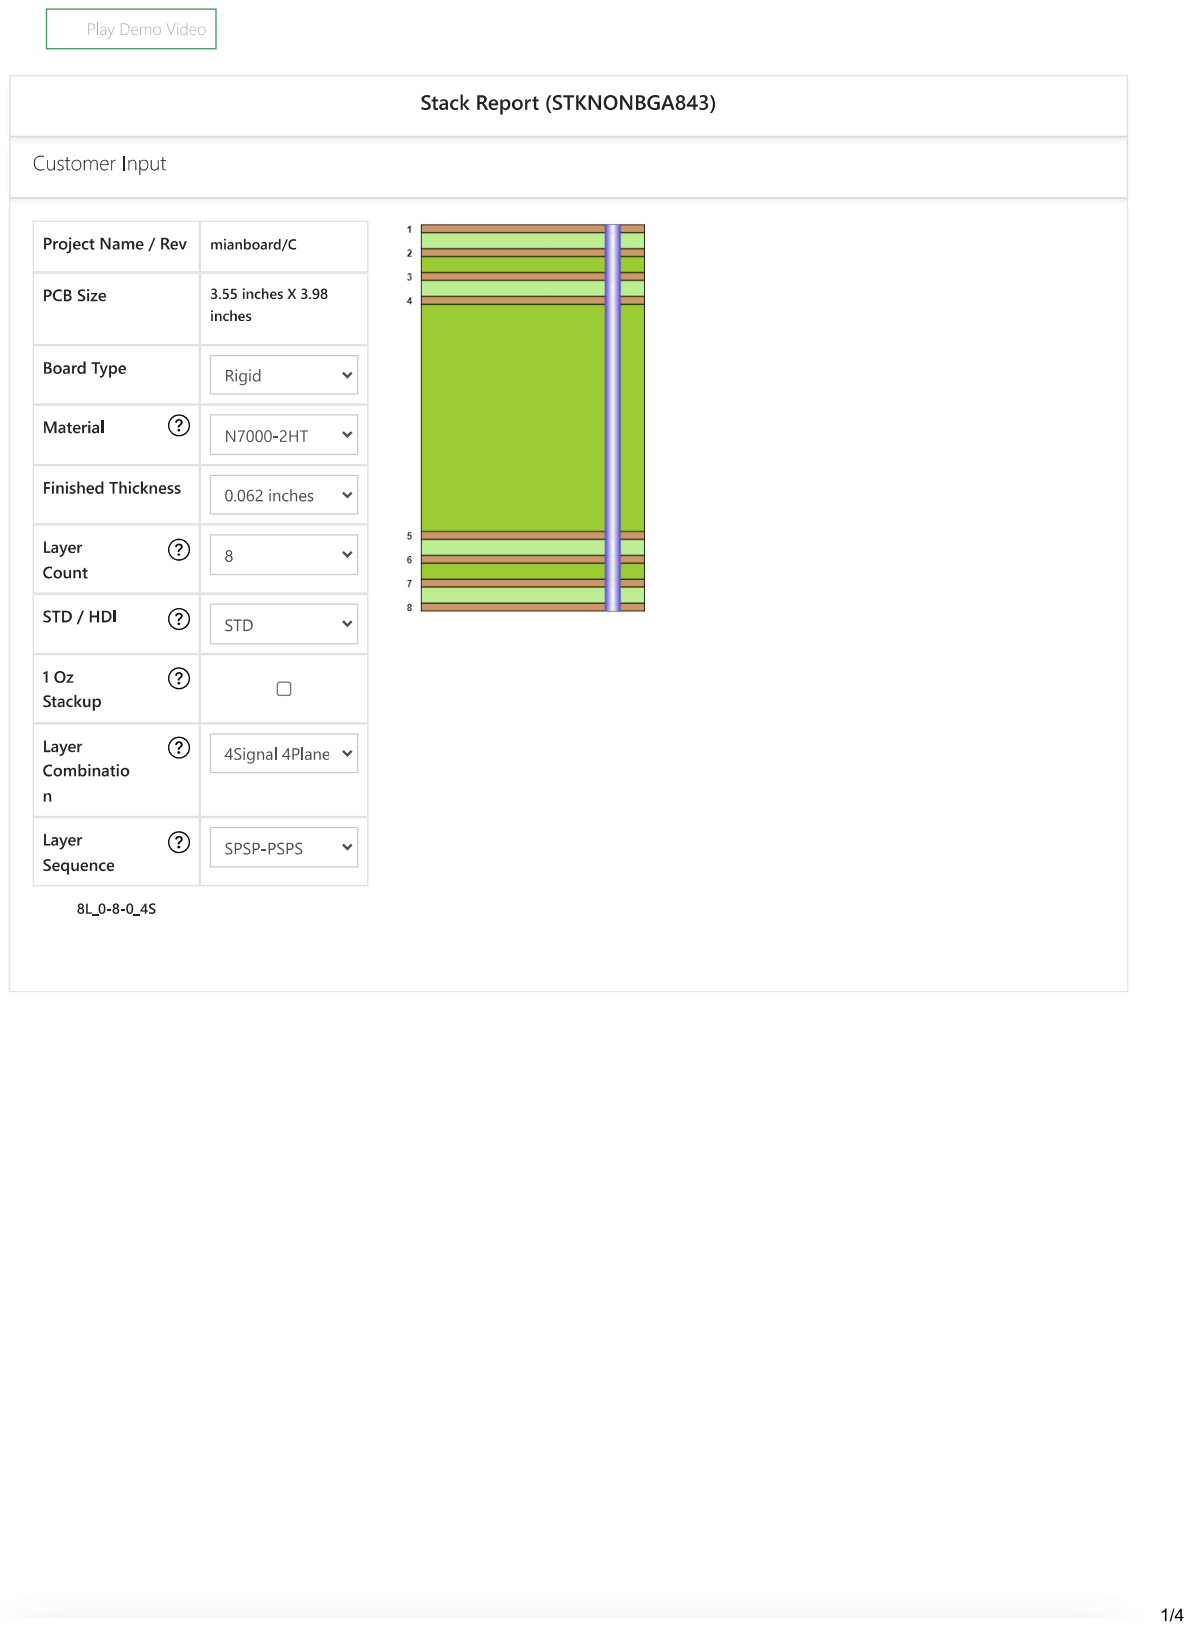
[picture p28: page 1]

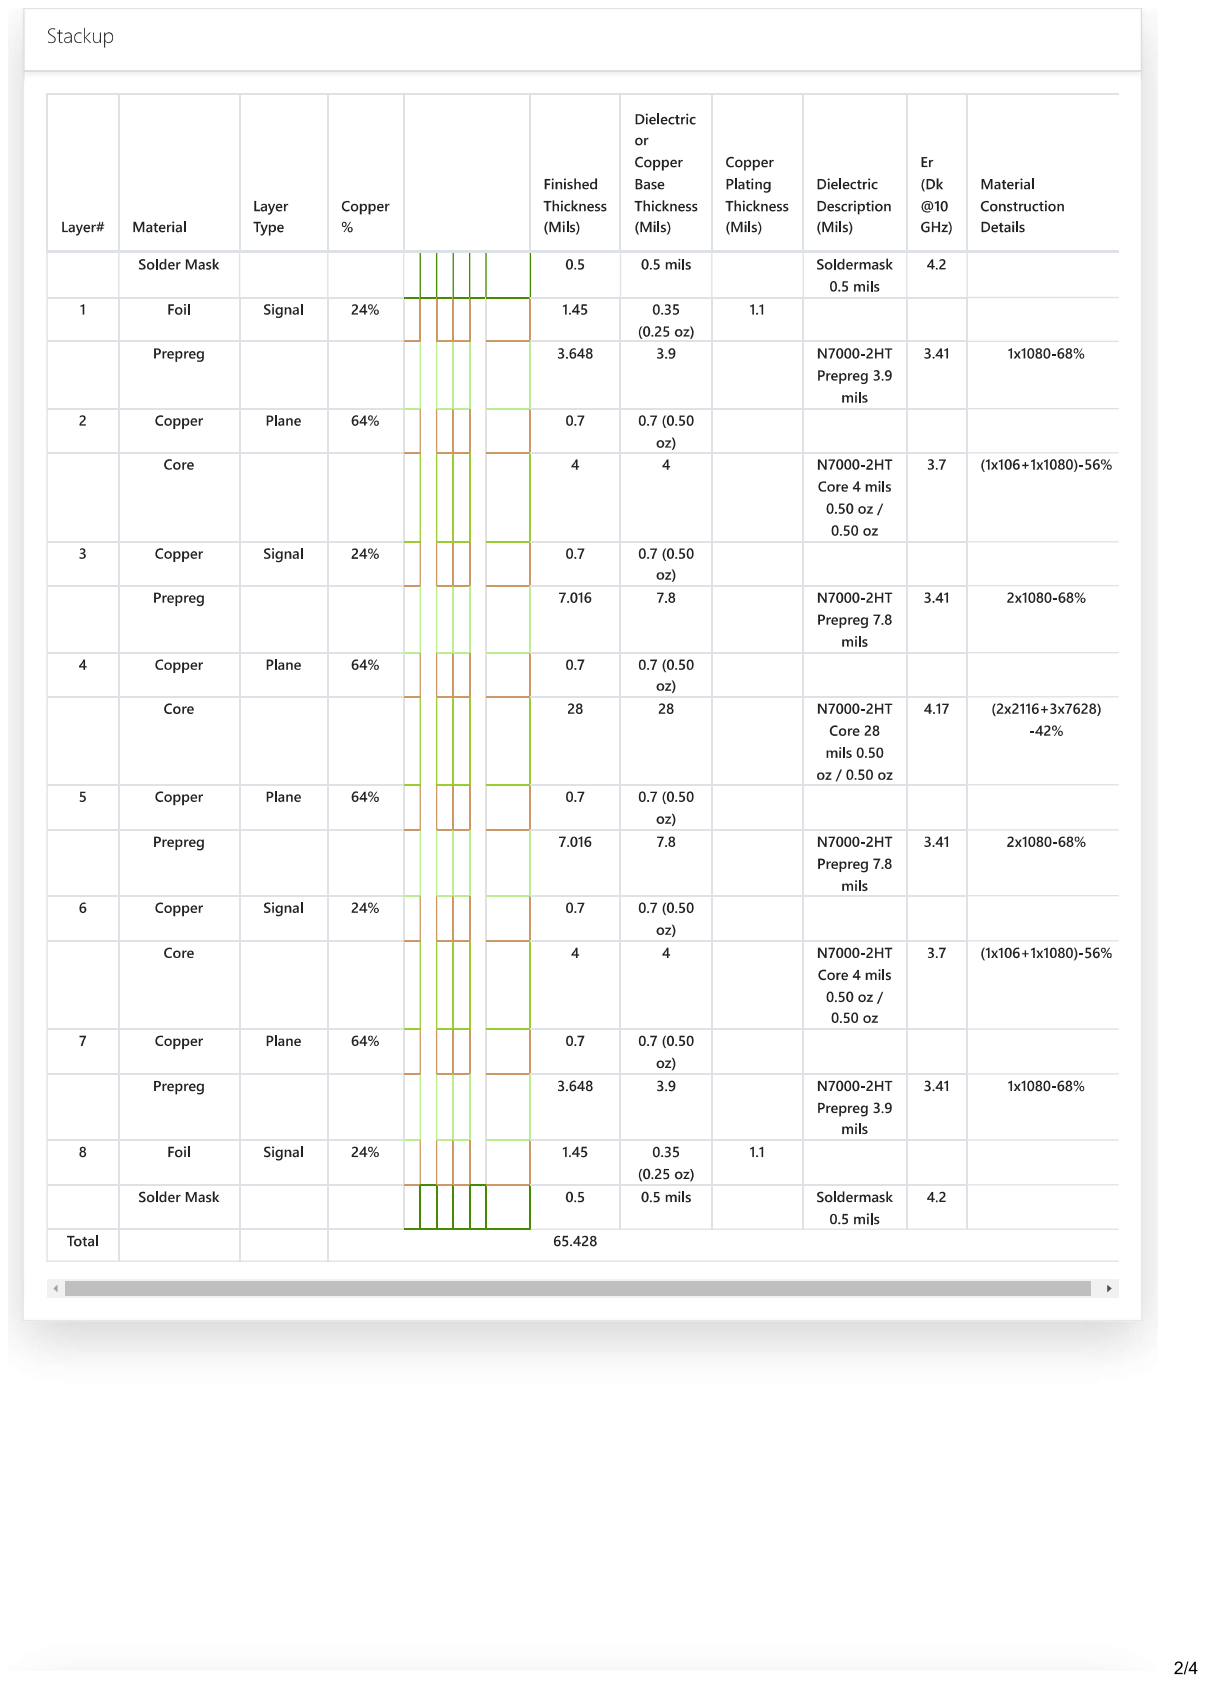
[picture p29: page 2]

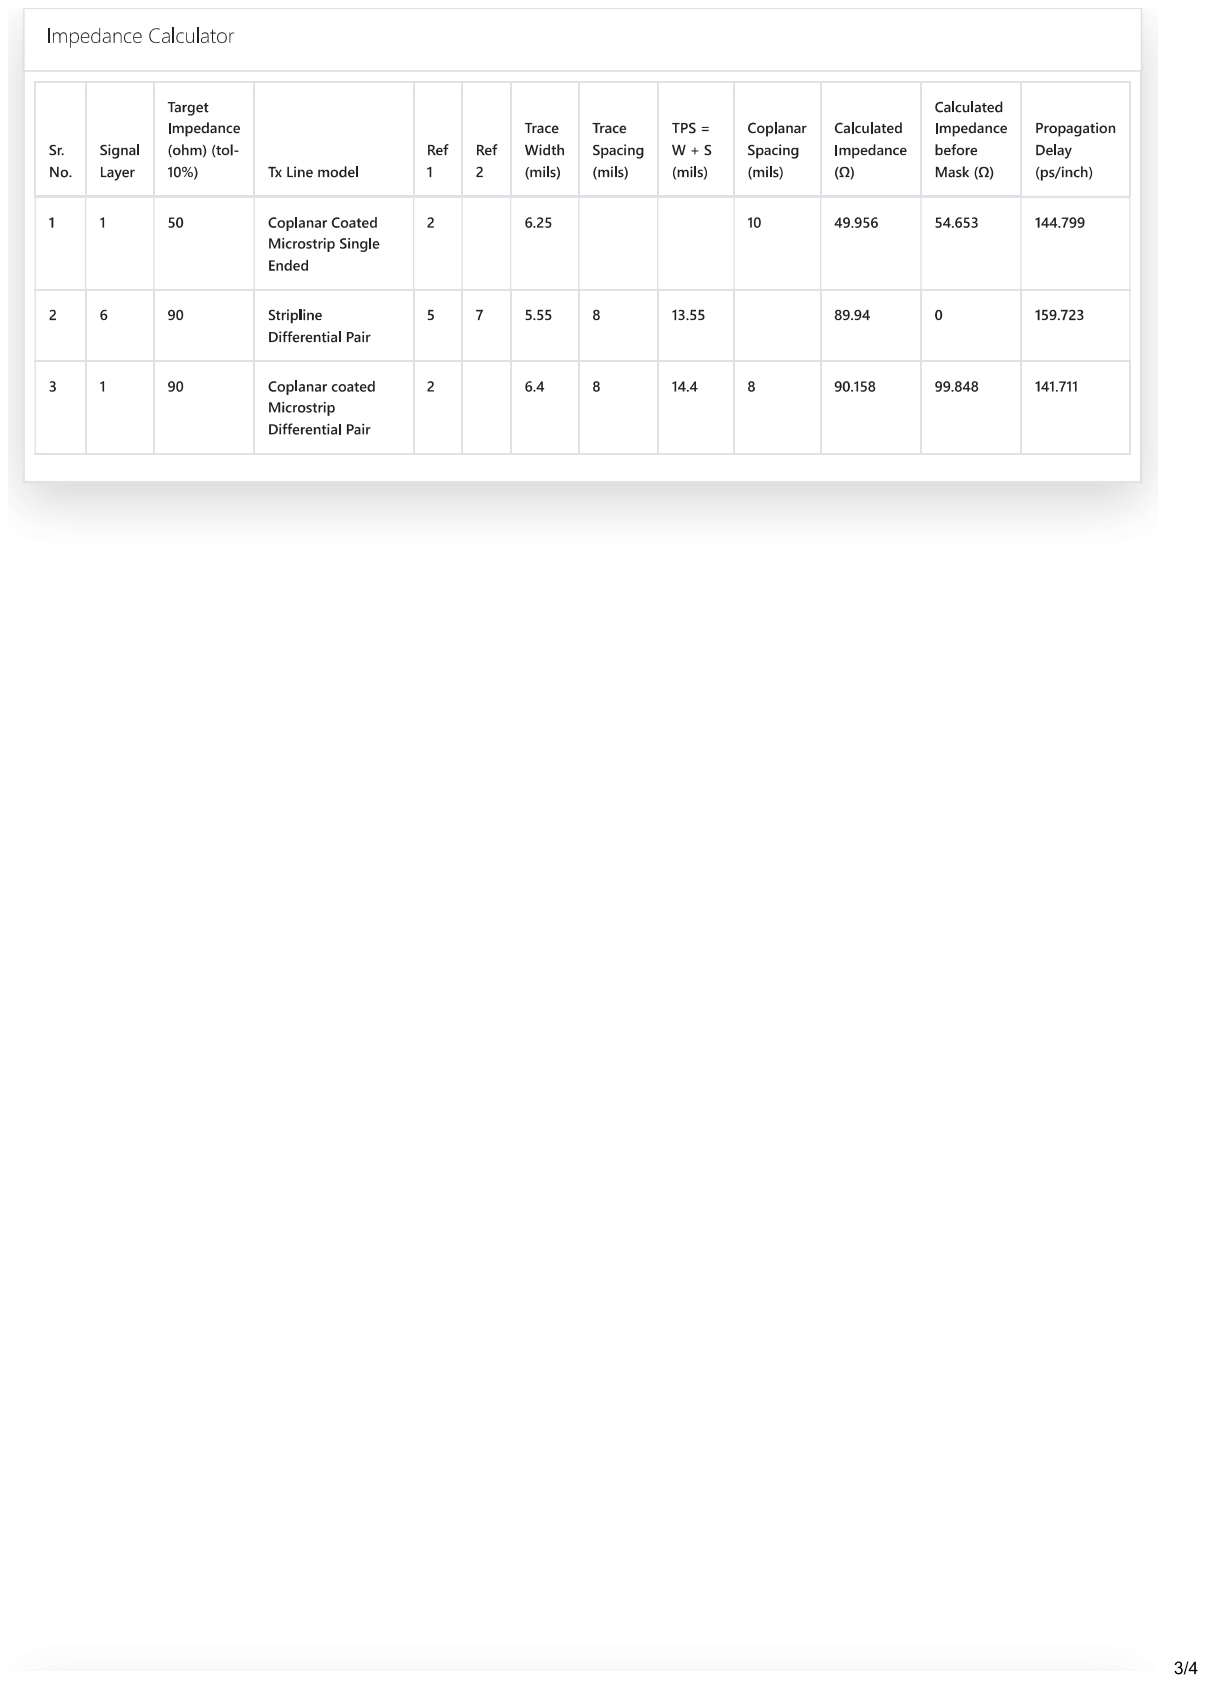
[picture p30: page 3]

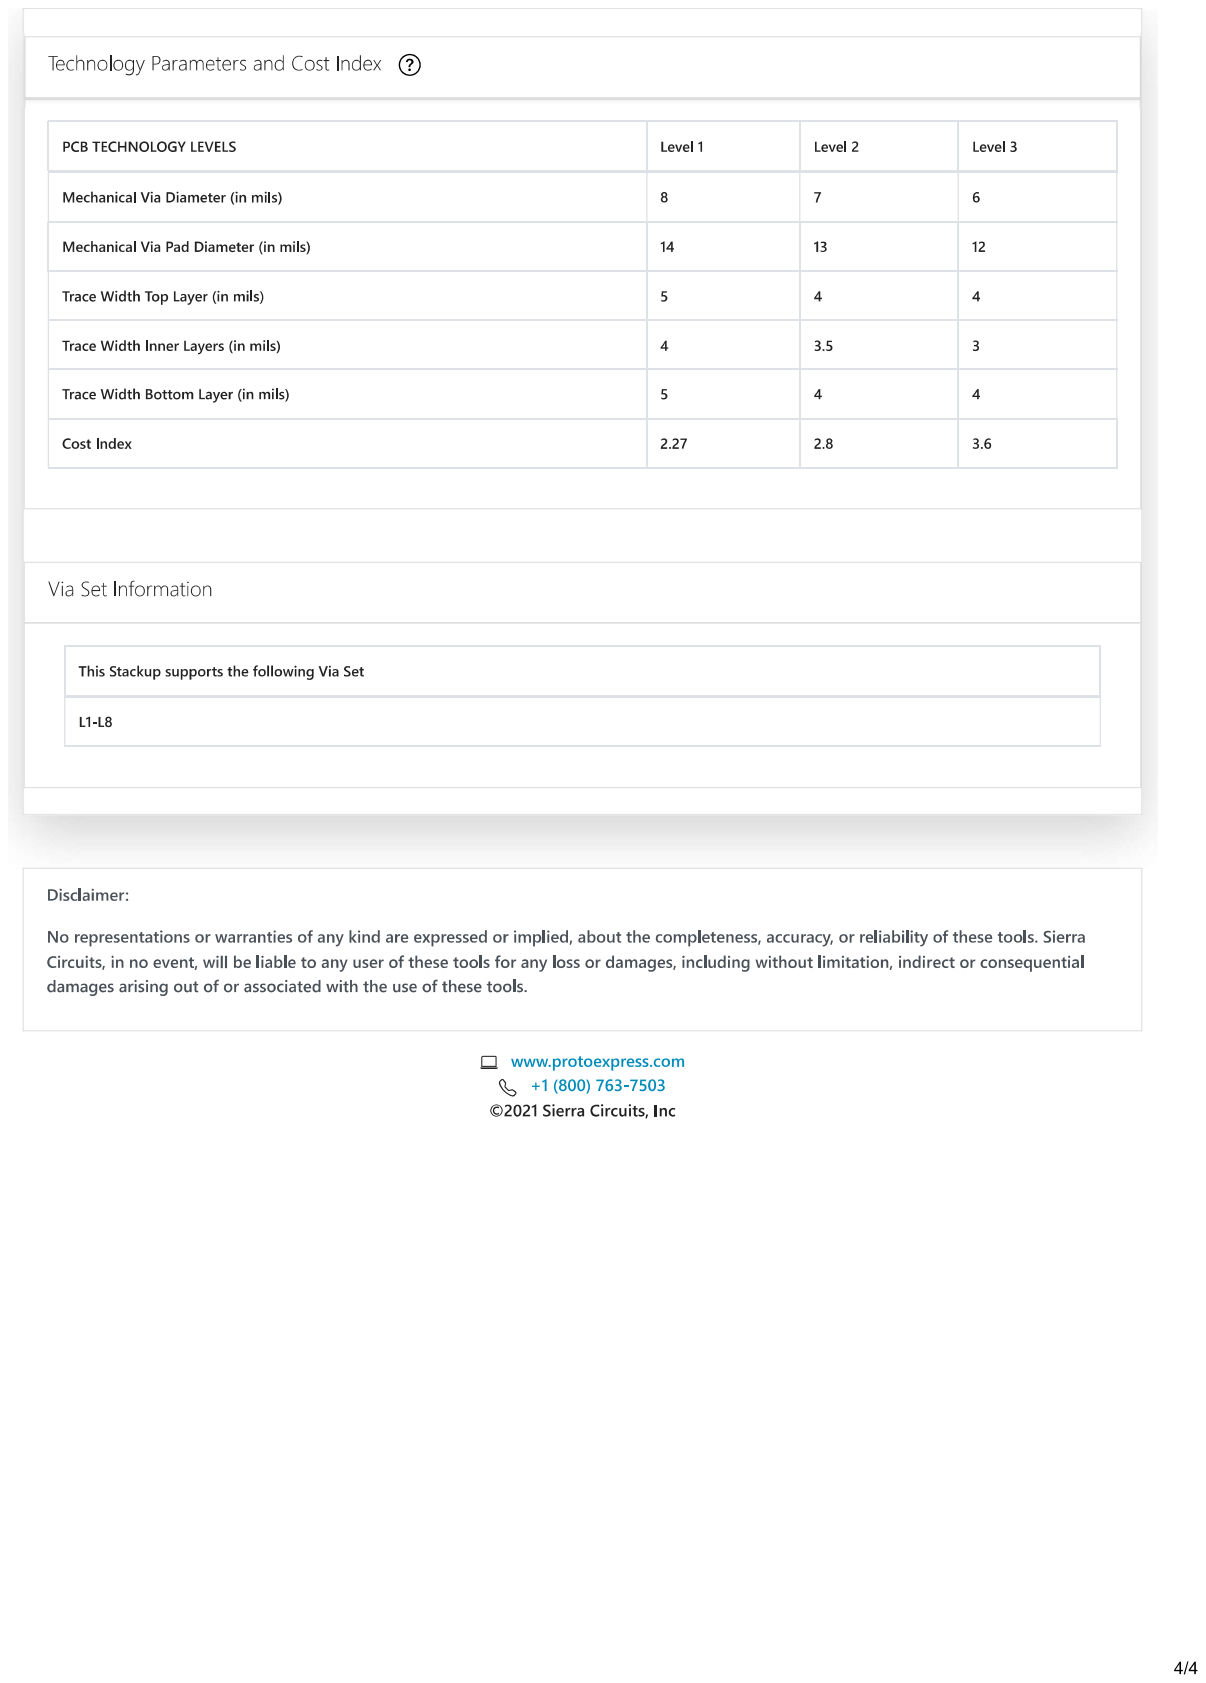
[picture p31: page 4]
