Sierra-Lobo/mainboard-hardware/design/lm335a/LM335_LM235_LM135_test.asc

R1: res; 5k
R2: res; 5k
R3: res; 5k
U1: lm335; LM135
U2: lm335; LM235
U3: lm335
VBAT: battery; 9
VTEMP: voltage; 23
Named nets: 0, TEMP1, V135, V235, V335
.op
.dc VTEMP 0 22.5 .5
.include LM135_LM235_LM335.lib
