Sierra-Lobo/mainboard-hardware/design/lm335a/lm335a_bias.asc

R1: res; 1.2k
U1: LT6004
U2: lm335
V2: voltage; 25
V3: voltage; 5V
Named nets: 0, TEMP, 5V
.dc v2 -40 150 1
