Sierra-Lobo/mainboard-hardware/(commit log)

2023-03-22 removed old commits
    [5V_regulator.kicad_sch, 5V_regulator.sch, Avionics.kicad_sch, Avionics.sch, Blank-Card-Default.kicad_sch, Blank-Card-Default.sch, Burn_Wires.kicad_sch, Burn_Wires.sch]
2023-03-24 working revC
    [5V_regulator.sch, Avionics.kicad_sch, Avionics.sch, Blank-Card-Default.sch, Burn_Wires.kicad_sch, Burn_Wires.sch, Bus_Protection.sch, Connectors.kicad_sch]
2023-04-04 routing fm
    [5V_regulator.kicad_sch, Avionics.kicad_sch, Burn_Wires.kicad_sch, Bus_Protection.kicad_sch, Power.kicad_sch, RF_and_GPS.kicad_sch, Solar Charge Regulator.kicad_sch, analog_mux.kicad_sch]
2023-05-07 updated analog , solar comp, layout
    [5V_regulator.kicad_sch, Avionics.kicad_sch, Blank-Card-Default.kicad_sch, Burn_Wires.kicad_sch, Bus_Protection.kicad_sch, Connectors.kicad_sch, Power.kicad_sch, RF_and_GPS.kicad_sch]
2023-05-17 fm layout
    [Avionics.kicad_sch, Blank-Card-Default.kicad_sch, Power.kicad_sch, RF_and_GPS.kicad_sch, inhibits.kicad_sch, mainboard.kicad_sch]
2023-05-19 changed RF connector to TH
    [5V_regulator.kicad_sch, Avionics.kicad_sch, Blank-Card-Default.kicad_sch, Burn_Wires.kicad_sch, Bus_Protection.kicad_sch, Power.kicad_sch, RF_and_GPS.kicad_sch, Solar Charge Regulator.kicad_sch]
2023-05-19 swaped LED PWR pin
    [mainboard.kicad_sch]
2023-05-30 working revC review changes
    [5V_regulator.kicad_sch, Avionics.kicad_sch, Blank-Card-Default.kicad_sch, Burn_Wires.kicad_sch, Bus_Protection.kicad_sch, Connectors.kicad_sch, IMU.kicad_sch, Power.kicad_sch]
2023-06-01 added OR'ing diode to inhibits high source
    [Power.kicad_sch, inhibits.kicad_sch]
2023-06-12 almost done!!!!!
    [3v3_reg.kicad_sch, 5V_regulator.kicad_sch, Blank-Card-Default.kicad_sch, Burn_Wires.kicad_sch, Connectors.kicad_sch, Energy Harvester.kicad_sch, Power.kicad_sch, RF_and_GPS.kicad_sch]
2023-06-12 re numbered pages
    [5V_regulator.kicad_sch, Bus_Protection.kicad_sch, Power.kicad_sch, analog_cond.kicad_sch, mainboard.kicad_sch, ocp_detector.kicad_sch]
2023-06-13 updated fab files
    [3v3_reg.kicad_sch, 5V_regulator.kicad_sch, Avionics.kicad_sch, Blank-Card-Default.kicad_sch, Burn_Wires.kicad_sch, Bus_Protection.kicad_sch, Power.kicad_sch, RF_and_GPS.kicad_sch]
2023-06-16 updated per review, improved docs
    [3v3_reg.kicad_sch, 5V_regulator.kicad_sch, Avionics.kicad_sch, Blank-Card-Default.kicad_sch, Burn_Wires.kicad_sch, Bus_Protection.kicad_sch, Power.kicad_sch, RF_and_GPS.kicad_sch]
2023-06-16 generated separate fab files for PCBway stackup
    [mainboard-B_Cu.gbl, mainboard-B_Mask.gbs, mainboard-B_Silkscreen.gbo, mainboard-Edge_Cuts.gm1, mainboard-F_Cu.gtl, mainboard-F_Mask.gts, mainboard-F_Silkscreen.gto, mainboard-NPTH-drl_map.gbr]
2023-06-16 bom edit
    [mainboard-revC-assy-vendor-bom.xlsx]
2023-06-16 bom type-o
    [mainboard-revC-assy-vendor-bom.xlsx, mainboard-revC-bom.xlsx]
